GachuhiWachira/CubeSat/LibreCube PCDU/LibreCube_Original_v3/README.md

# LibreCube / Platform / Power / Power Module

A basic Power Conditioning and Distribution Unit (PCDU) that
implements a full redundancy scheme and adheres to the LibreCube board
specification. The main features are:

- Input connectors for up to six solar cells (in configurations for up to 5 Volt)
- Conditioning of input power (linear energy transfer mode)
- Two Li-Ion batteries integrated on board
- Charge and discharge circuitry for batteries, depending on solar input and load
- Main power switch that disconnects all electrical loads from solar cell input and batteries
- Stable 5 Volt output power to attached loads
- Eight output switches for switchable loads

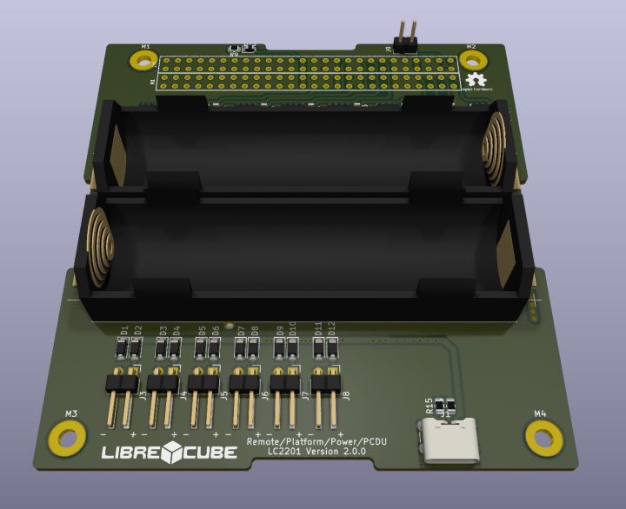
[picture p1: LibreCube PCDU/LibreCube_Original_v3/docs/image_01.png]


The user manual can be found [here](docs/manual/README.md).

## How to Build

See [here](docs/assembly/README.md) for instructions.

## How to Modify

The `src` folder contains the [KiCAD](https://www.kicad.org/) source files.

## Contribute

To learn more on how to successfully contribute please read the contributing
information in the [LibreCube Guidelines](https://librecube.gitlab.io/).

Want to get involved? Join us at [Matrix](https://app.element.io/#/room/#librecube.org:matrix.org)
or via [Email](mailto:info@librecube.org).

## License

The project is licensed under the CERN Open Hardware license.
See the [LICENSE](./LICENSE.txt) file for details.
