GachuhiWachira/CubeSat/LibreCube PCDU/LibreCube Board Template/src/mechanical/board without header with hole.FCStd

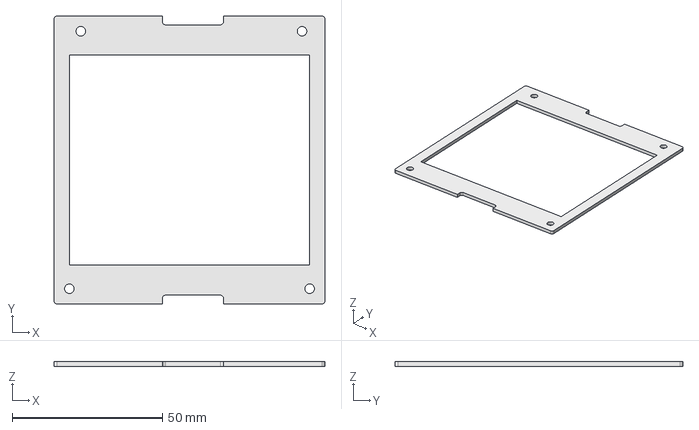
[picture p4: CAD file, 2024-09-18]
LibreCube PCDU/LibreCube Board Template/src/mechanical/board without header with hole.FCStd
90.2 x 95.9 x 1.57 mm
