GachuhiWachira/CubeSat/LibreCube PCDU/LibreCube Board Template/src/mechanical/board_2d_projection.scad

projection(cut=true) import("board.stl");
