GachuhiWachira/CubeSat/LibreCube PCDU/LibreCube_Original_v3/build/schematics.pdf

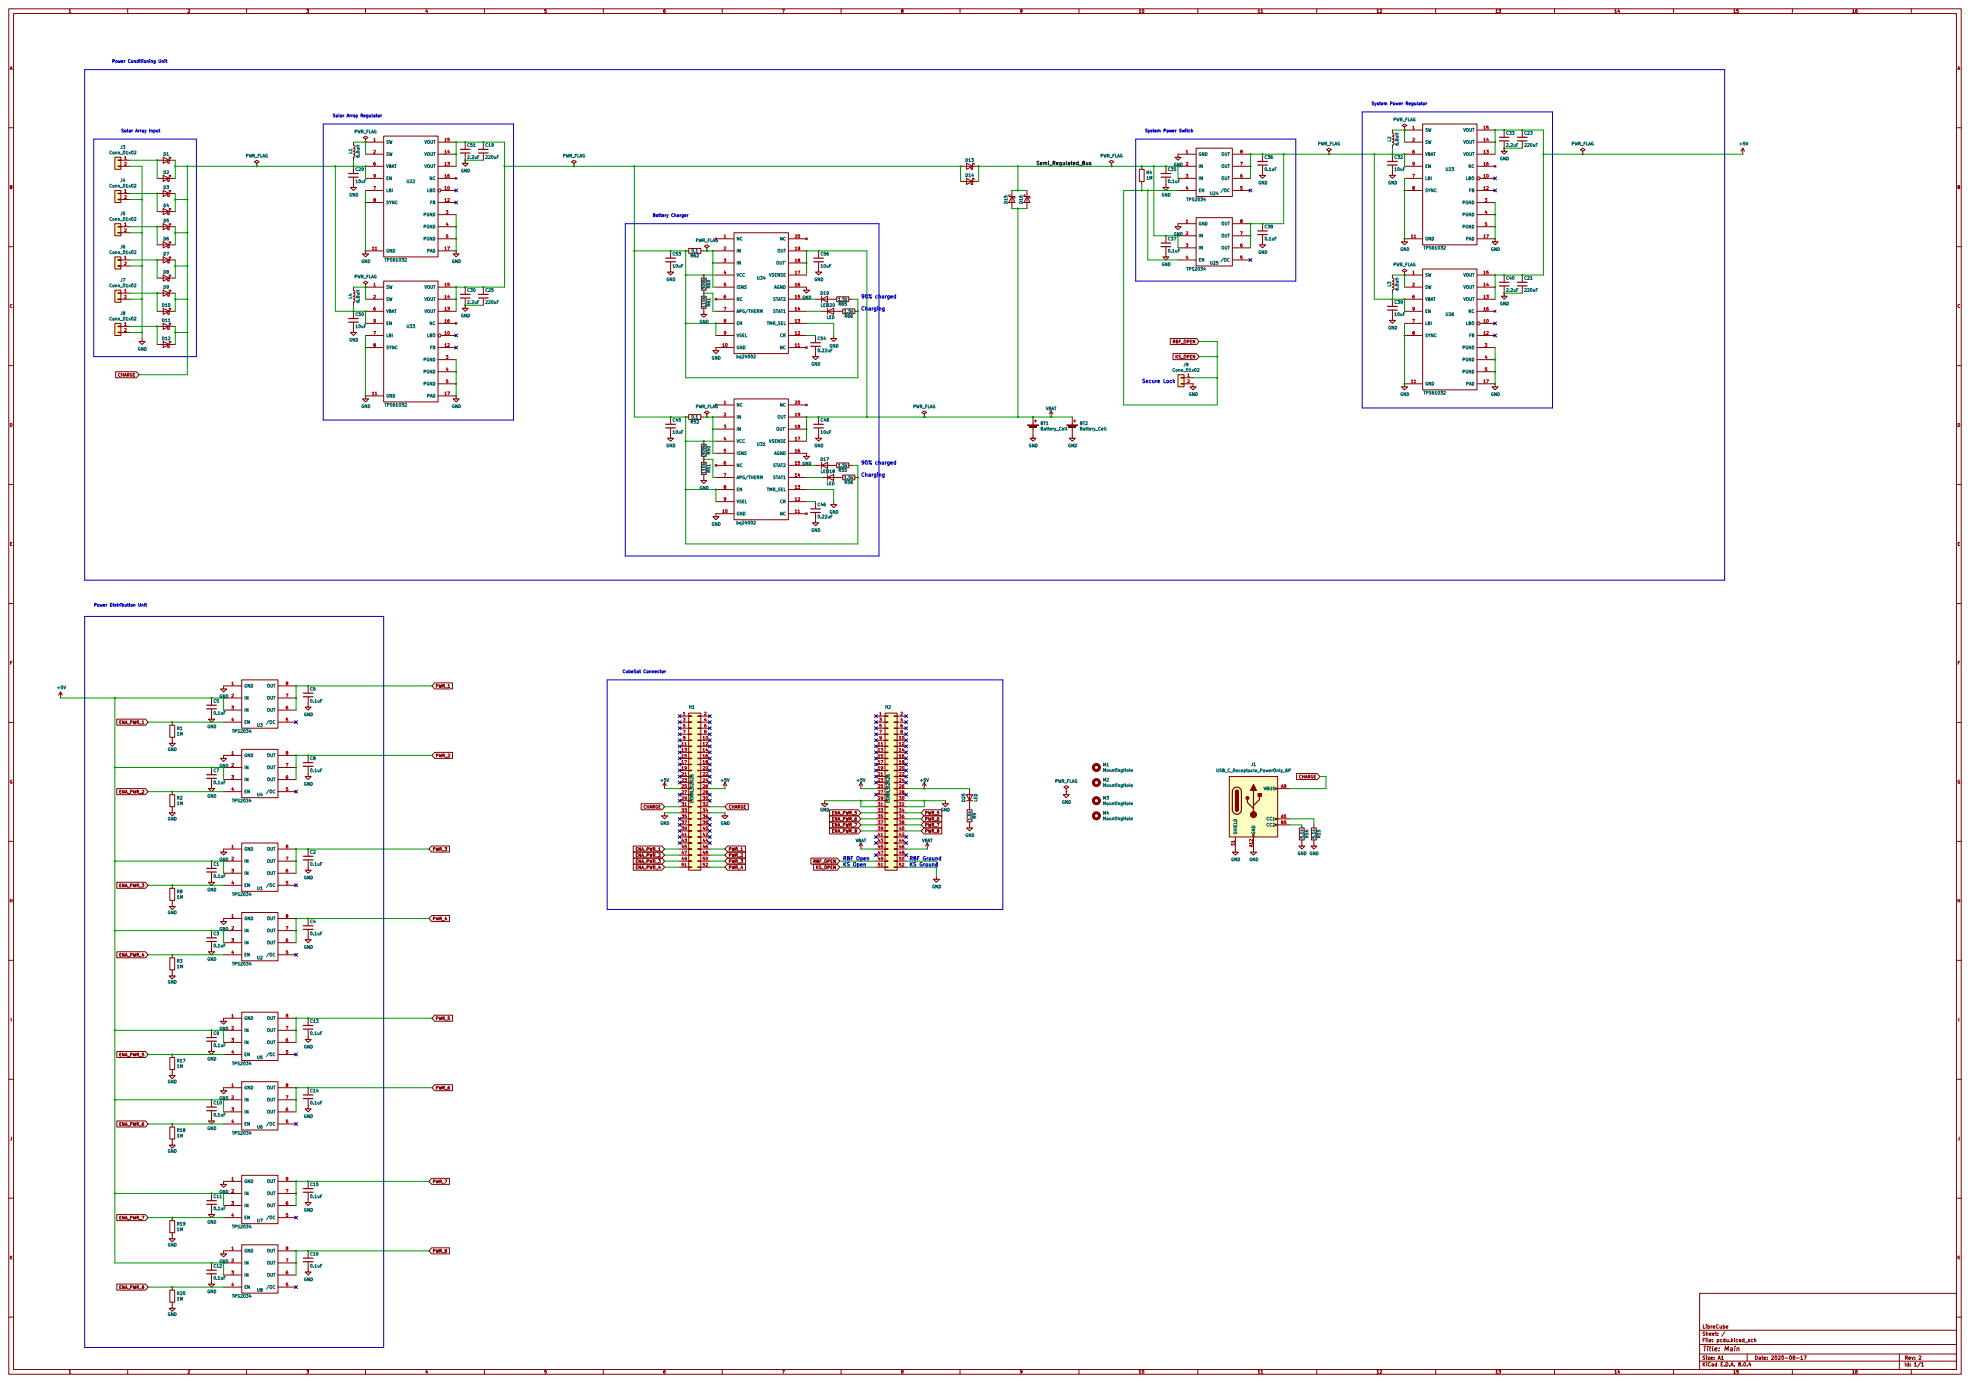
[picture p9: page 1]
