GachuhiWachira/CubeSat/LibreCube PCDU/LibreCube_Original_v2/build/schematics.pdf

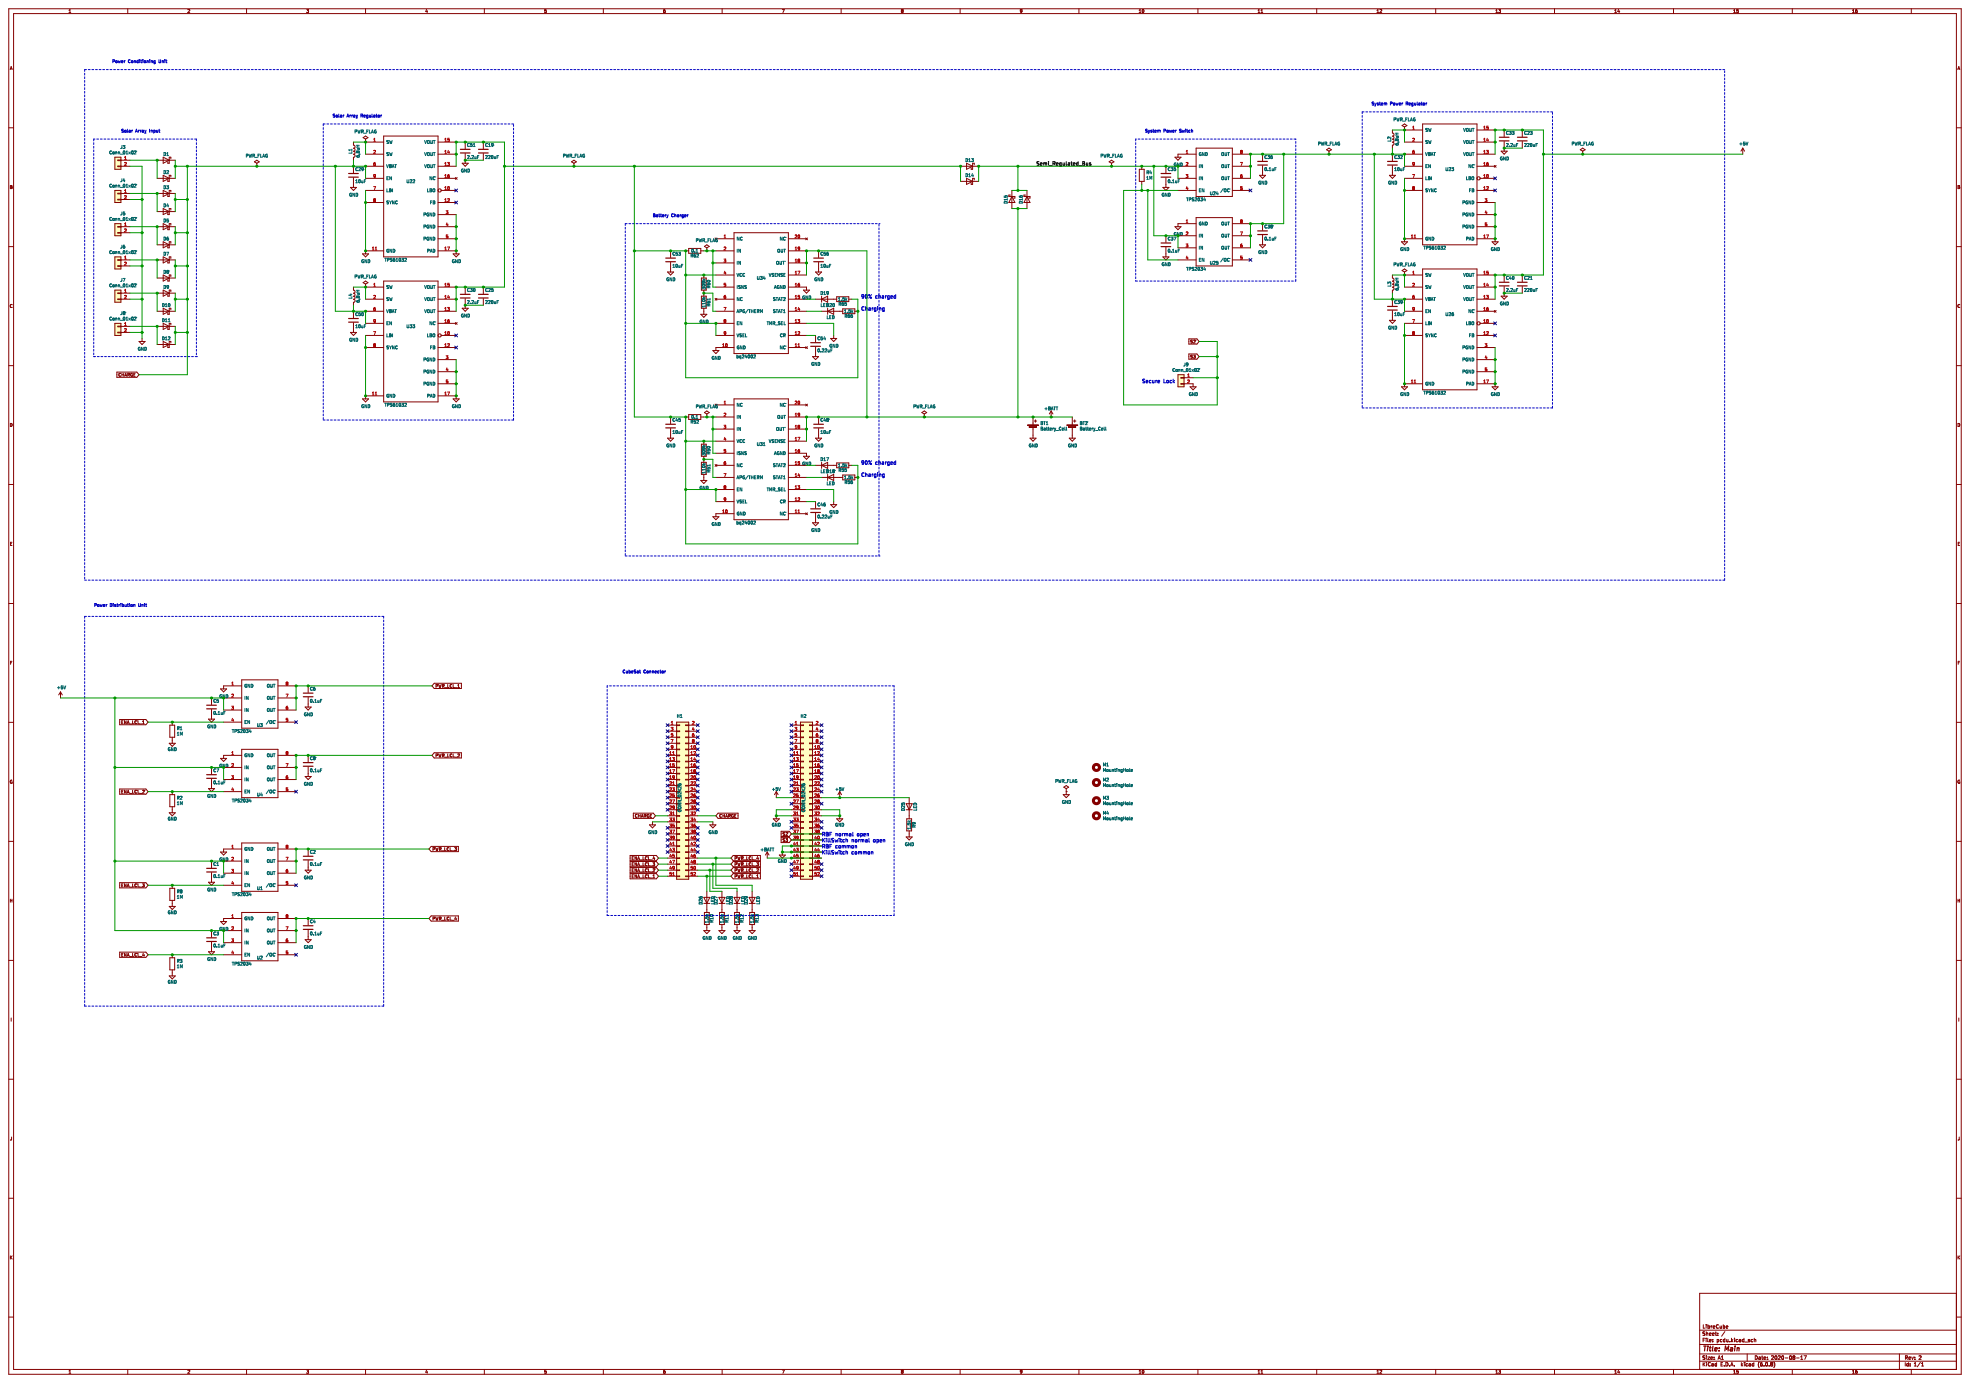
[picture p10: page 1]
