GachuhiWachira/CubeSat/LibreCube PCDU/My version/src/electrical/my_pcdu_v1.kicad_pcb

## KiCad design LibreCube PCDU/My version/src/electrical/my_pcdu_v1.kicad_pcb (2025-06-23)

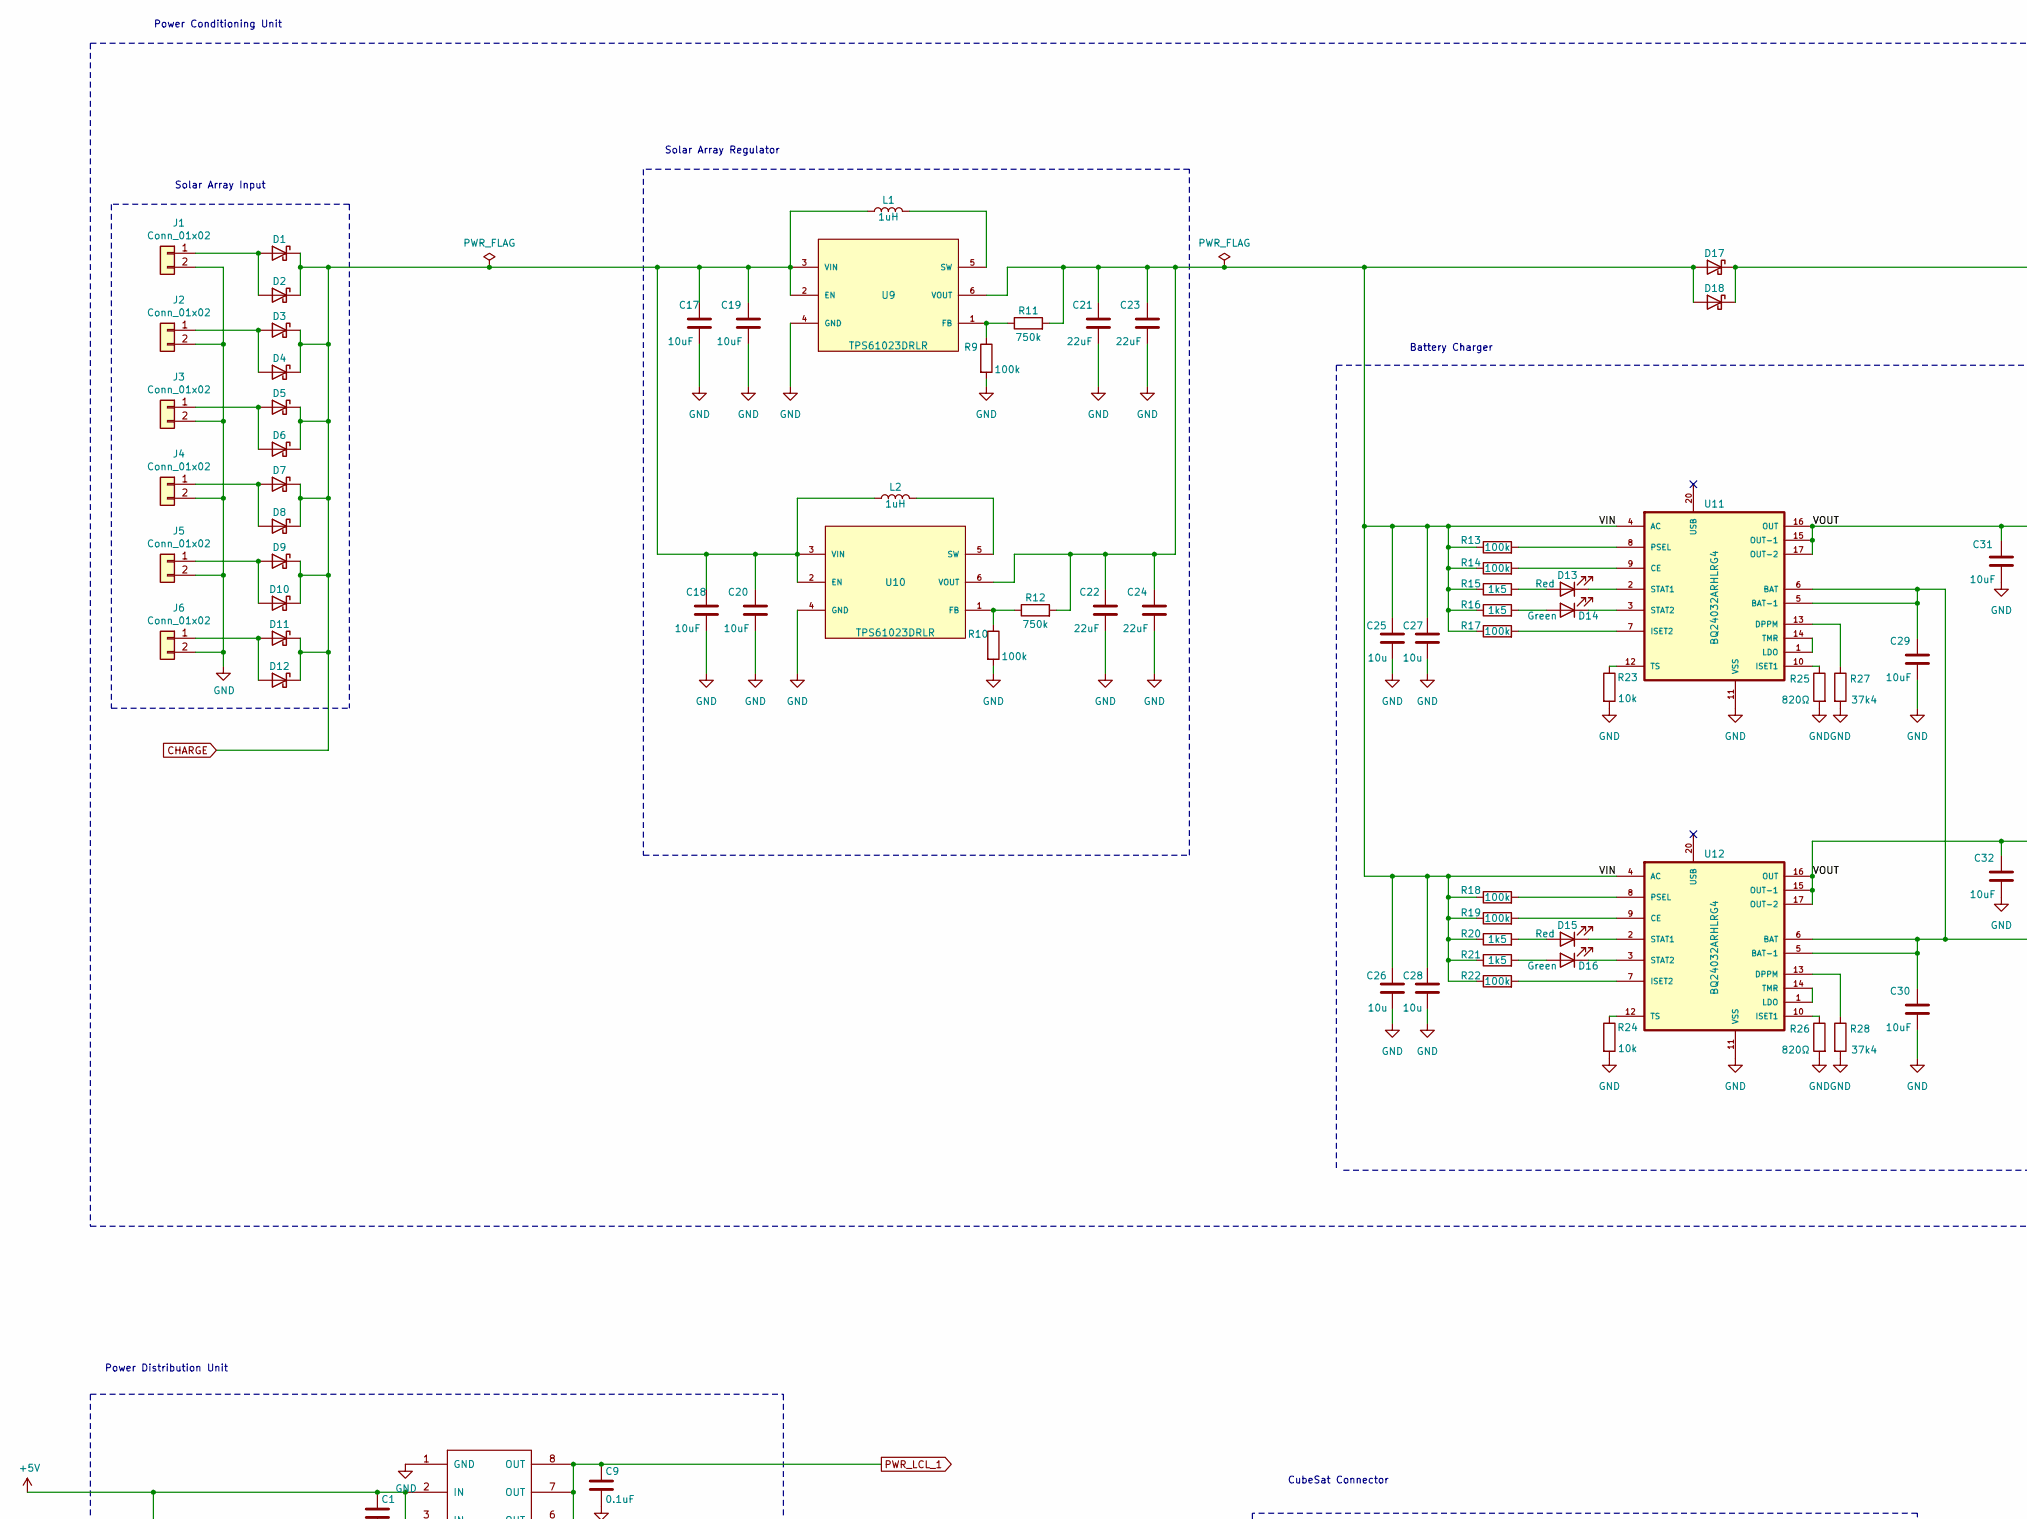
[picture p11: schematic my_pcdu_v1.kicad_sch, LibreCube PCDU 4-Layer (LC2201), part in row 1, column 1]

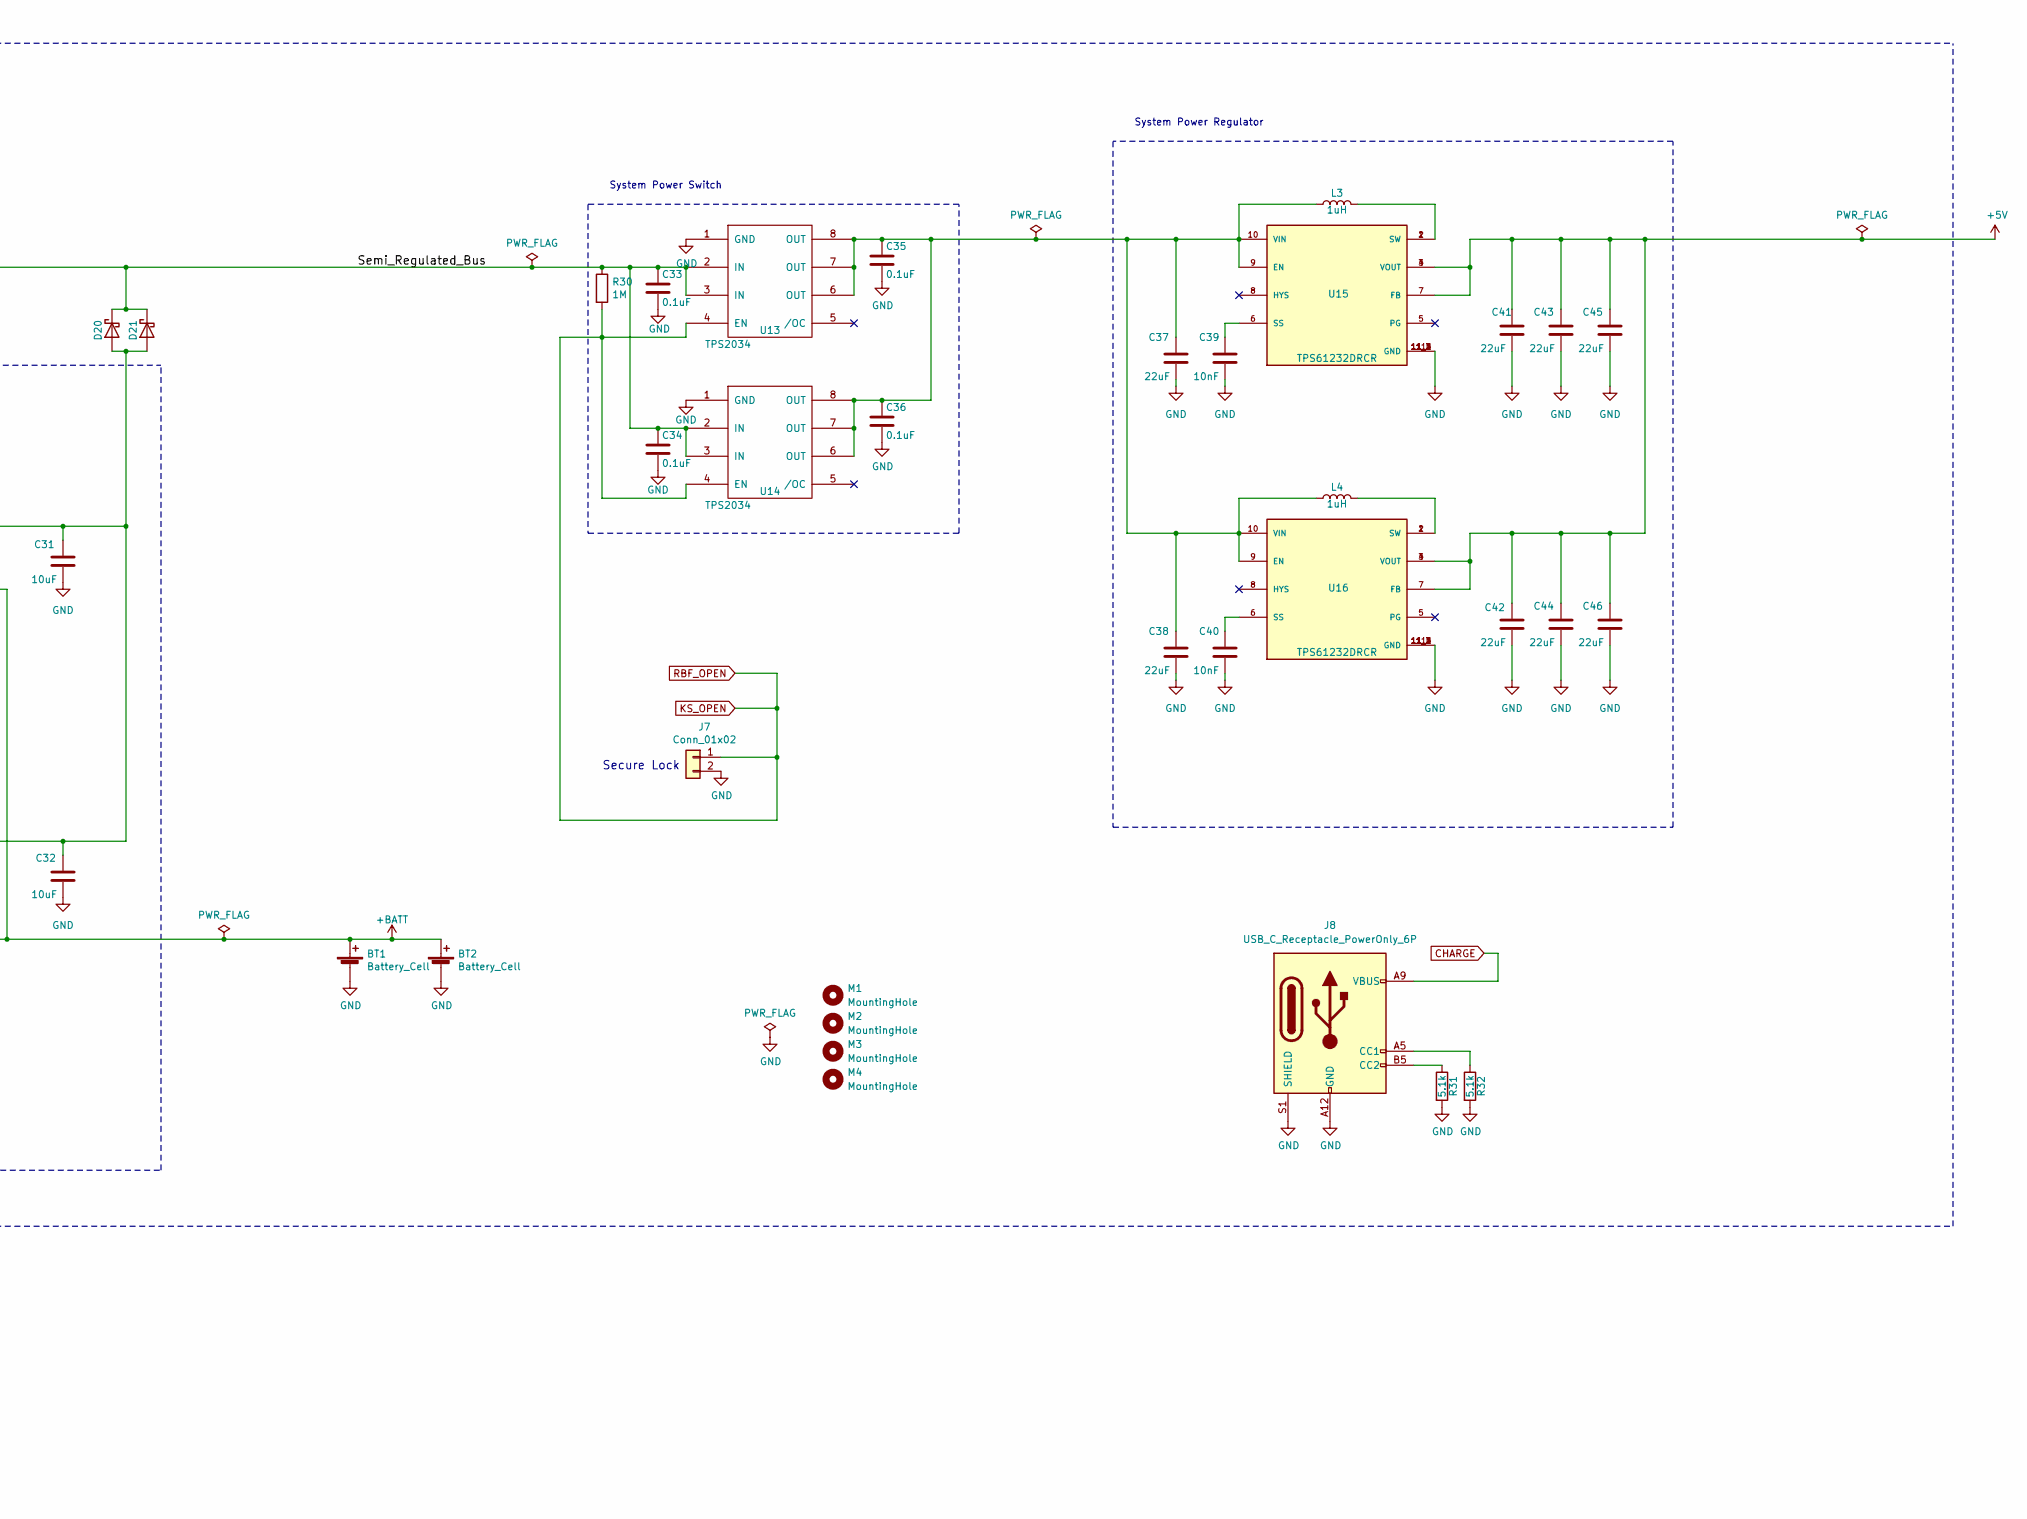
[picture p12: schematic my_pcdu_v1.kicad_sch, LibreCube PCDU 4-Layer (LC2201), part in row 1, column 2]

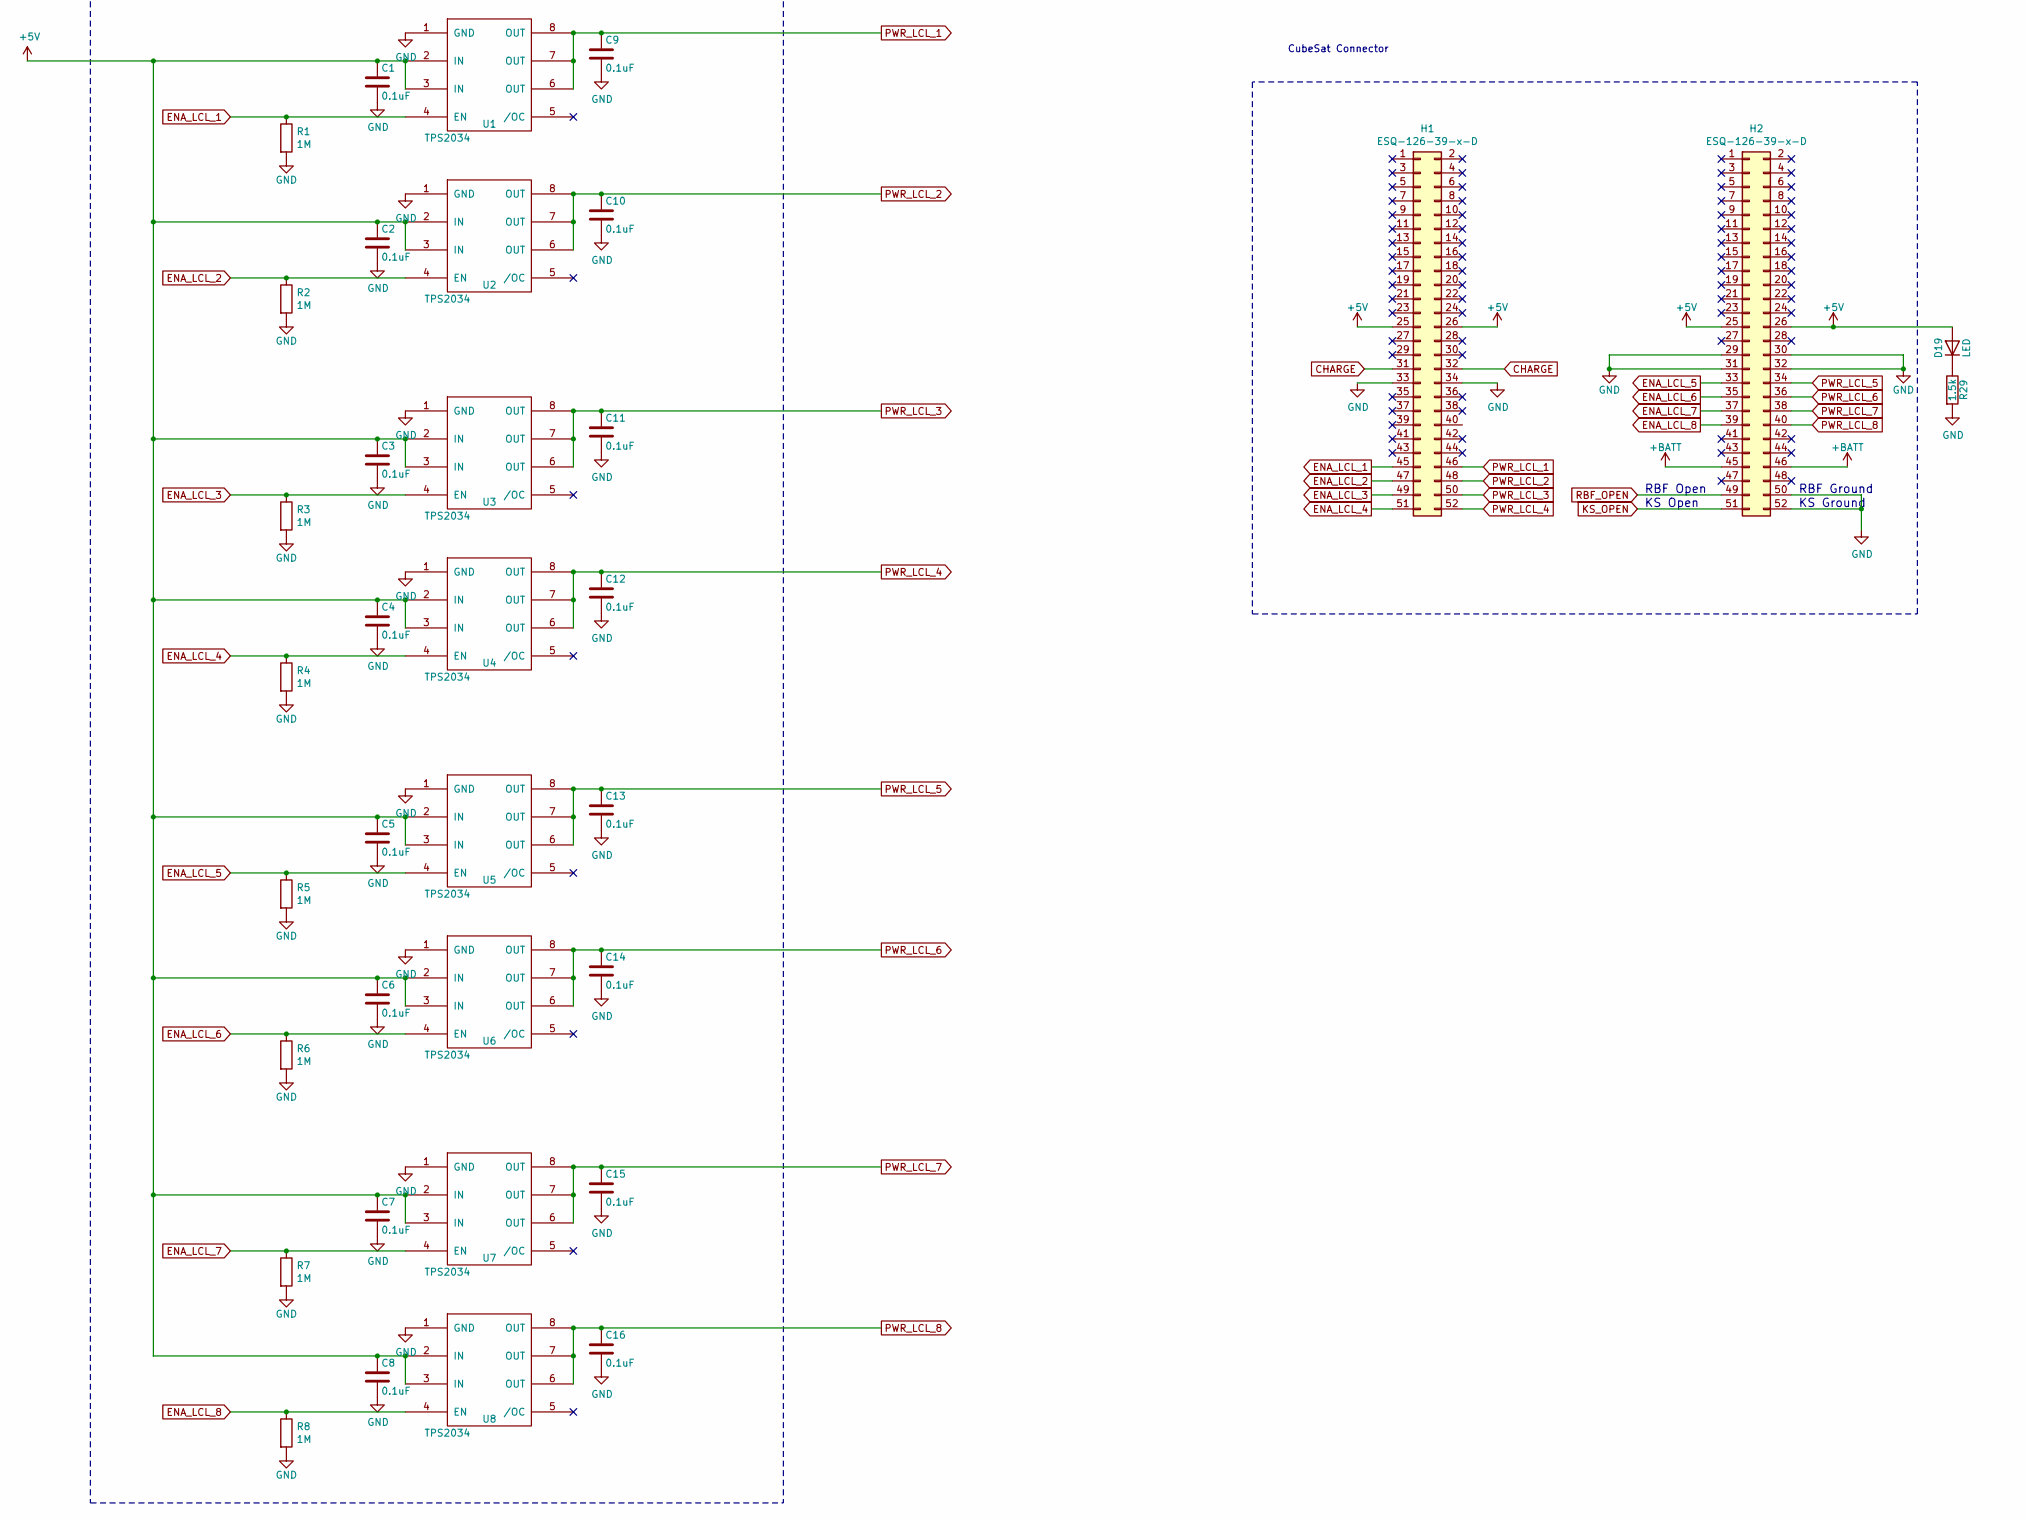
[picture p13: schematic my_pcdu_v1.kicad_sch, LibreCube PCDU 4-Layer (LC2201), part in row 2, column 1]

Parts:
BT1, BT2: Battery_Cell; BatteryHolder_Keystone_1042_1x18650
C1, C2, C3, C4, C5, C6, C7, C8, C9, C10, C11, C12, C13, C14, C15, C16, C33, C34, C35, C36: 0.1uF; C_0805_2012Metric
C17, C18, C19, C20, C29, C30, C31, C32: 10uF; C_0805_2012Metric_Pad1.18x1.45mm_HandSolder
C21, C22, C23, C24, C37, C38, C41, C42, C43, C44, C45, C46: 22uF; C_0805_2012Metric_Pad1.18x1.45mm_HandSolder
C25, C26, C27, C28: 10u; C_1206_3216Metric_Pad1.33x1.80mm_HandSolder
C39, C40: 10nF; C_0805_2012Metric_Pad1.18x1.45mm_HandSolder
D1, D2, D3, D4, D5, D6, D7, D8, D9, D10, D11, D12, D17, D18, D20, D21: D_Schottky; D_SOD-123
D13, D15: Red; LED_0805_2012Metric_Pad1.15x1.40mm_HandSolder
D14, D16: Green; LED_0805_2012Metric_Pad1.15x1.40mm_HandSolder
D19: LED; D_0805_2012Metric
H1, H2: ESQ-126-39-x-D; PinHeader_2x26_P2.54mm_Vertical
J1, J2, J3, J4, J5, J6: Conn_01x02; PinHeader_1x02_P2.54mm_Horizontal
J7: Conn_01x02; PinHeader_1x02_P2.54mm_Vertical
J8: USB_C_Receptacle_PowerOnly_6P; USB_C_Receptacle_GCT_USB4125-xx-x-0190_6P_TopMnt_Horizontal
L1, L2, L3, L4: 1uH; L_Coilcraft_XAL4040-XXX
M1, M2, M3, M4: MountingHole; MountingHole_3.2mm_M3_Pad
R1, R2, R3, R4, R5, R6, R7, R8, R30: 1M; R_0805_2012Metric
R9, R10, R13, R14, R17, R18, R19, R22: 100k; R_0805_2012Metric_Pad1.20x1.40mm_HandSolder
R11, R12: 750k; R_0805_2012Metric_Pad1.20x1.40mm_HandSolder
R15, R16, R20, R21: 1k5; R_0805_2012Metric_Pad1.20x1.40mm_HandSolder
R23, R24: 10k; R_0805_2012Metric_Pad1.20x1.40mm_HandSolder
R25, R26: 820Ω; R_0805_2012Metric_Pad1.20x1.40mm_HandSolder
R27, R28: 37k4; R_0805_2012Metric_Pad1.20x1.40mm_HandSolder
R29: 1.5k; R_0805_2012Metric
R31, R32: 5.1k; R_0805_2012Metric
REF1: Logo_Open_Hardware_Small; OSHW-Logo_5.7x6mm_SilkScreen
U1, U2, U3, U4, U5, U6, U7, U8, U13, U14: TPS2034; SO-8_3.9x4.9mm_P1.27mm
U9, U10: TPS61023DRLR; DRL0006A; PARTNUMBER TPS61023DRL
U11, U12: BQ24032ARHLRG4; IC_MSP430FR2522IRHLR
U15, U16: TPS61232DRCR; VREG_TPS61232DRCR; PARTREV C

Connections:
+5V: C1.1, C2.1, C3.1, C4.1, C5.1, C6.1, C7.1, C8.1, C41.1, C42.1, C43.1, C44.1, C45.1, C46.1, D19.2 (A), H1.25, H1.26, H2.25, H2.26, U1.2 (IN), U1.3 (IN), U2.2 (IN), U2.3 (IN), U3.2 (IN), U3.3 (IN), U4.2 (IN), U4.3 (IN), U5.2 (IN), U5.3 (IN), U6.2 (IN), U6.3 (IN), U7.2 (IN), U7.3 (IN), U8.2 (IN), U8.3 (IN), U15.3 (VOUT), U15.4 (VOUT), U15.7 (FB), U16.3 (VOUT), U16.4 (VOUT), U16.7 (FB)
+BATT: BT1.1 (+), BT2.1 (+), C29.1, C30.1, H2.45, H2.46, U11.5 (BAT-1), U11.6 (BAT), U12.5 (BAT-1), U12.6 (BAT)
/Semi_Regulated_Bus: C33.1, C34.1, D17.1 (K), D18.1 (K), D20.1 (K), D21.1 (K), R30.1, U13.2 (IN), U13.3 (IN), U14.2 (IN), U14.3 (IN)
/VIN: C21.1, C22.1, C23.1, C24.1, C25.1, C26.1, C27.1, C28.1, D17.2 (A), D18.2 (A), R11.2, R12.2, R13.1, R14.1, R15.1, R16.1, R17.1, R18.1, R19.1, R20.1, R21.1, R22.1, U9.6 (VOUT), U10.6 (VOUT), U11.4 (AC), U12.4 (AC)
/VOUT: C31.1, C32.1, D20.2 (A), D21.2 (A), U11.15 (OUT-1), U11.16 (OUT), U11.17 (OUT-2), U12.15 (OUT-1), U12.16 (OUT), U12.17 (OUT-2)
CHARGE: C17.1, C18.1, C19.1, C20.1, D1.1 (K), D2.1 (K), D3.1 (K), D4.1 (K), D5.1 (K), D6.1 (K), D7.1 (K), D8.1 (K), D9.1 (K), D10.1 (K), D11.1 (K), D12.1 (K), H1.31, H1.32, J8.A9 (VBUS), J8.B9 (VBUS), L1.1, L2.1, U9.2 (EN), U9.3 (VIN), U10.2 (EN), U10.3 (VIN)
ENA_LCL_1: H1.45, R1.1, U1.4 (EN)
ENA_LCL_2: H1.47, R2.1, U2.4 (EN)
ENA_LCL_3: H1.49, R3.1, U3.4 (EN)
ENA_LCL_4: H1.51, R4.1, U4.4 (EN)
ENA_LCL_5: H2.33, R5.1, U5.4 (EN)
ENA_LCL_6: H2.35, R6.1, U6.4 (EN)
ENA_LCL_7: H2.37, R7.1, U7.4 (EN)
ENA_LCL_8: H2.39, R8.1, U8.4 (EN)
GND: BT1.2 (-), BT2.2 (-), C1.2, C2.2, C3.2, C4.2, C5.2, C6.2, C7.2, C8.2, C9.2, C10.2, C11.2, C12.2, C13.2, C14.2, C15.2, C16.2, C17.2, C18.2, C19.2, C20.2, C21.2, C22.2, C23.2, C24.2, C25.2, C26.2, C27.2, C28.2, C29.2, C30.2, C31.2, C32.2, C33.2, C34.2, C35.2, C36.2, C37.2, C38.2, C39.2, C40.2, C41.2, C42.2, C43.2, C44.2, C45.2, C46.2, H1.33, H1.34, H2.29, H2.30, H2.31, H2.32, H2.50, H2.52, J1.2, J2.2, J3.2, J4.2, J5.2, J6.2, J7.2, J8.A12 (GND), J8.B12 (GND), J8.S1 (SHIELD), R1.2, R2.2, R3.2, R4.2, R5.2, R6.2, R7.2, R8.2, R9.2, R10.2, R23.2, R24.2, R25.2, R26.2, R27.2, R28.2, R29.2, R31.2, R32.2, U1.1 (GND), U2.1 (GND), U3.1 (GND), U4.1 (GND), U5.1 (GND), U6.1 (GND), U7.1 (GND), U8.1 (GND), U9.4 (GND), U10.4 (GND), U11.11 (VSS), U11.21 (PwrPad), U11.22, U11.23, U11.24, U11.25, U11.26, U11.27, U11.28, U11.29, U12.11 (VSS), U12.21 (PwrPad), U12.22, U12.23, U12.24, U12.25, U12.26, U12.27, U12.28, U12.29, U13.1 (GND), U14.1 (GND), U15.11 (GND), U15.11_1 (GND), U15.11_2 (GND), U15.11_3 (GND), U15.11_4 (GND), U16.11 (GND), U16.11_1 (GND), U16.11_2 (GND), U16.11_3 (GND), U16.11_4 (GND)
KS_OPEN: H2.49, H2.51, J7.1, R30.2, U13.4 (EN), U14.4 (EN)
unnamed: D1.2 (A), D2.2 (A), J1.1
unnamed: D3.2 (A), D4.2 (A), J2.1
unnamed: D5.2 (A), D6.2 (A), J3.1
unnamed: D7.2 (A), D8.2 (A), J4.1
unnamed: D9.2 (A), D10.2 (A), J5.1
unnamed: D11.2 (A), D12.2 (A), J6.1
unnamed: D13.2 (A), R15.2
unnamed: D13.1 (K), U11.2 (STAT1)
unnamed: D14.2 (A), R16.2
unnamed: D14.1 (K), U11.3 (STAT2)
unnamed: D15.2 (A), R20.2
unnamed: D15.1 (K), U12.2 (STAT1)
unnamed: D16.2 (A), R21.2
unnamed: D16.1 (K), U12.3 (STAT2)
unnamed: D19.1 (K), R29.1
unnamed: J8.A5 (CC1), R32.1
unnamed: J8.B5 (CC2), R31.1
unnamed: L3.2, U15.1 (SW), U15.2 (SW)
unnamed: L4.2, U16.1 (SW), U16.2 (SW)
unnamed: R9.1, R11.1, U9.1 (FB)
unnamed: L1.2, U9.5 (SW)
unnamed: R10.1, R12.1, U10.1 (FB)
unnamed: L2.2, U10.5 (SW)
unnamed: R14.2, U11.9 (CE)
unnamed: R27.1, U11.13 (DPPM)
unnamed: R25.1, U11.10 (ISET1)
unnamed: R17.2, U11.7 (ISET2)
unnamed: U11.1 (LDO), U11.14 (TMR)
unnamed: R13.2, U11.8 (PSEL)
unnamed: R23.1, U11.12 (TS)
unnamed: R19.2, U12.9 (CE)
unnamed: R28.1, U12.13 (DPPM)
unnamed: R26.1, U12.10 (ISET1)
unnamed: R22.2, U12.7 (ISET2)
unnamed: U12.1 (LDO), U12.14 (TMR)
unnamed: R18.2, U12.8 (PSEL)
unnamed: R24.1, U12.12 (TS)
unnamed: C35.1, C36.1, C37.1, C38.1, L3.1, L4.1, U13.6 (OUT), U13.7 (OUT), U13.8 (OUT), U14.6 (OUT), U14.7 (OUT), U14.8 (OUT), U15.9 (EN), U15.10 (VIN), U16.9 (EN), U16.10 (VIN)
unnamed: C39.1, U15.6 (SS)
unnamed: C40.1, U16.6 (SS)
PWR_LCL_1: C9.1, H1.46, U1.6 (OUT), U1.7 (OUT), U1.8 (OUT)
PWR_LCL_2: C10.1, H1.48, U2.6 (OUT), U2.7 (OUT), U2.8 (OUT)
PWR_LCL_3: C11.1, H1.50, U3.6 (OUT), U3.7 (OUT), U3.8 (OUT)
PWR_LCL_4: C12.1, H1.52, U4.6 (OUT), U4.7 (OUT), U4.8 (OUT)
PWR_LCL_5: C13.1, H2.34, U5.6 (OUT), U5.7 (OUT), U5.8 (OUT)
PWR_LCL_6: C14.1, H2.36, U6.6 (OUT), U6.7 (OUT), U6.8 (OUT)
PWR_LCL_7: C15.1, H2.38, U7.6 (OUT), U7.7 (OUT), U7.8 (OUT)
PWR_LCL_8: C16.1, H2.40, U8.6 (OUT), U8.7 (OUT), U8.8 (OUT)

Notes on the sheet:
KS Open
Solar Array Input
Solar Array Regulator
Power Distribution Unit
Secure Lock
System Power Switch
KS Ground
RBF Open
System Power Regulator
Battery Charger
CubeSat Connector
Power Conditioning Unit
RBF Ground

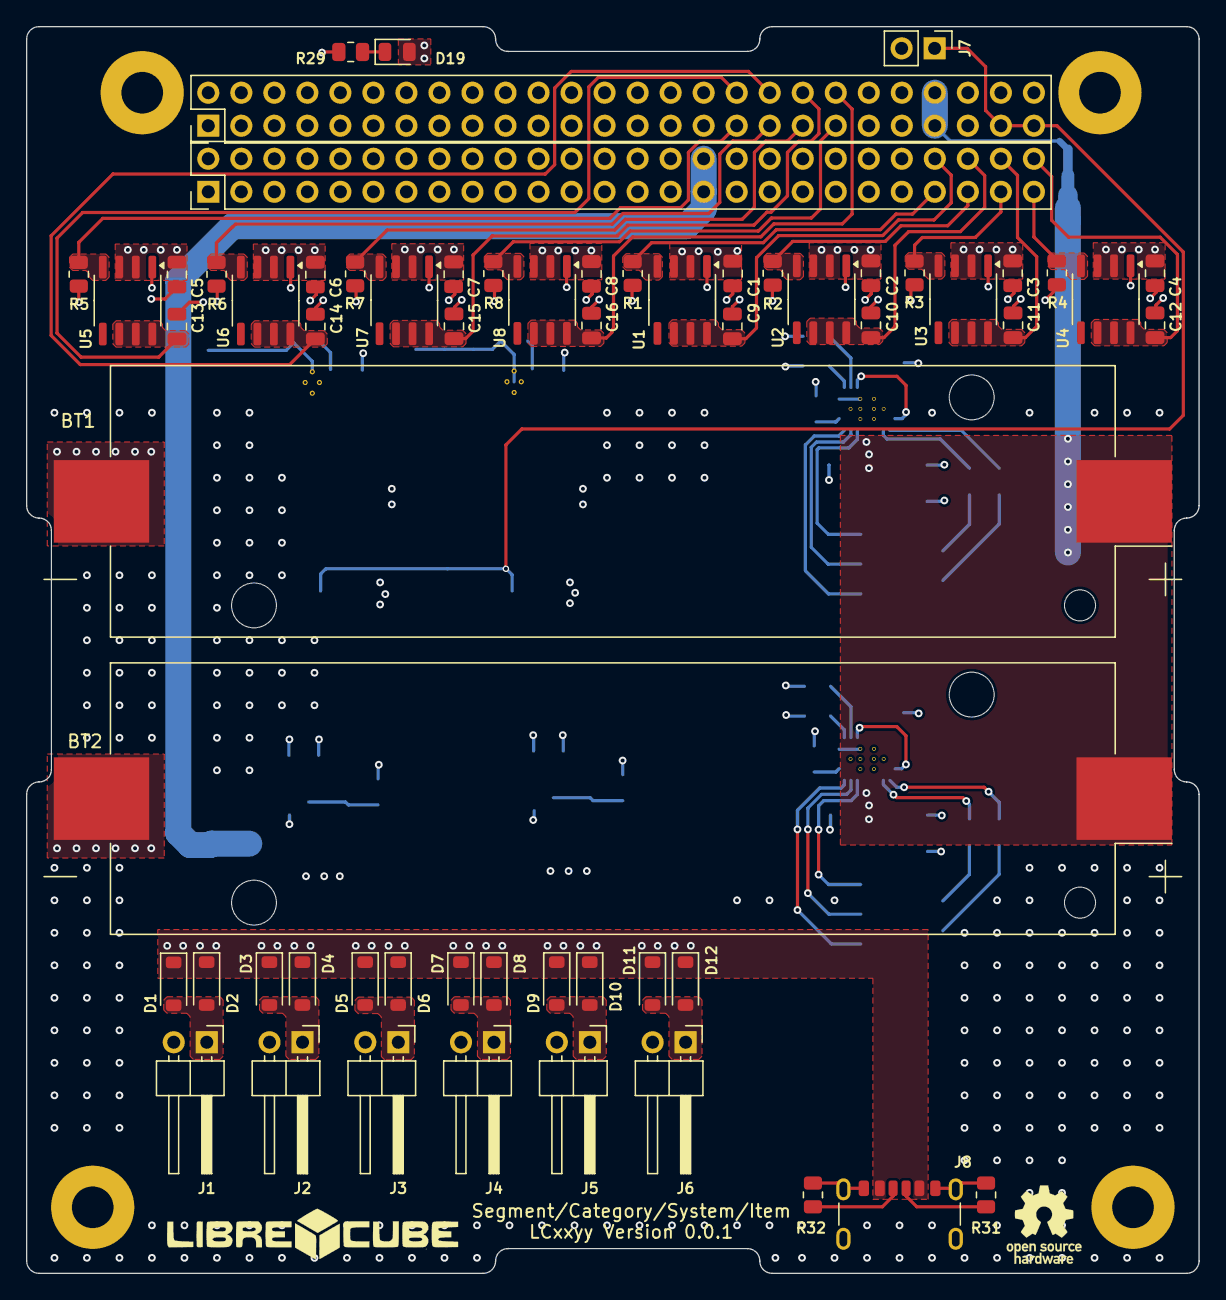
[picture p14: board my_pcdu_v1.kicad_pcb from above]

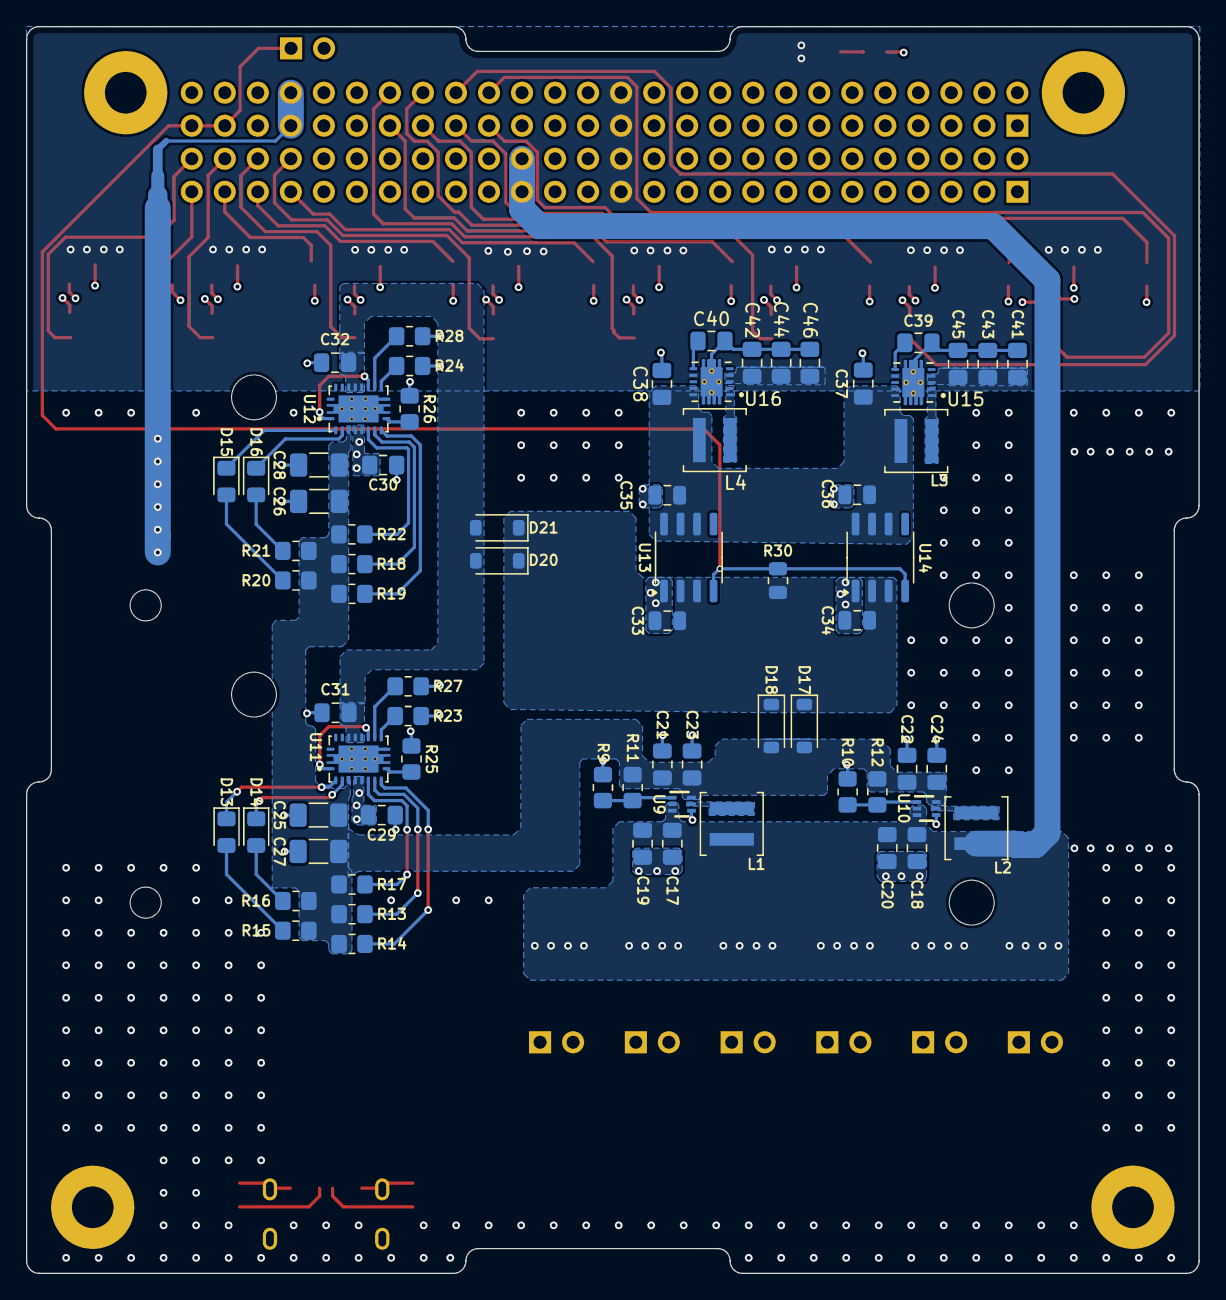
[picture p15: board my_pcdu_v1.kicad_pcb from below]

Board: 4 copper layers, 90.2 x 95.9 mm, 136 parts (71 on the bottom side), 64 nets.
