GachuhiWachira/CubeSat/LibreCube PCDU/LibreCube_Original_v3/src/electrical/pcdu.kicad_pcb

## KiCad design LibreCube PCDU/LibreCube_Original_v3/src/electrical/pcdu.kicad_pcb (2024-09-27)

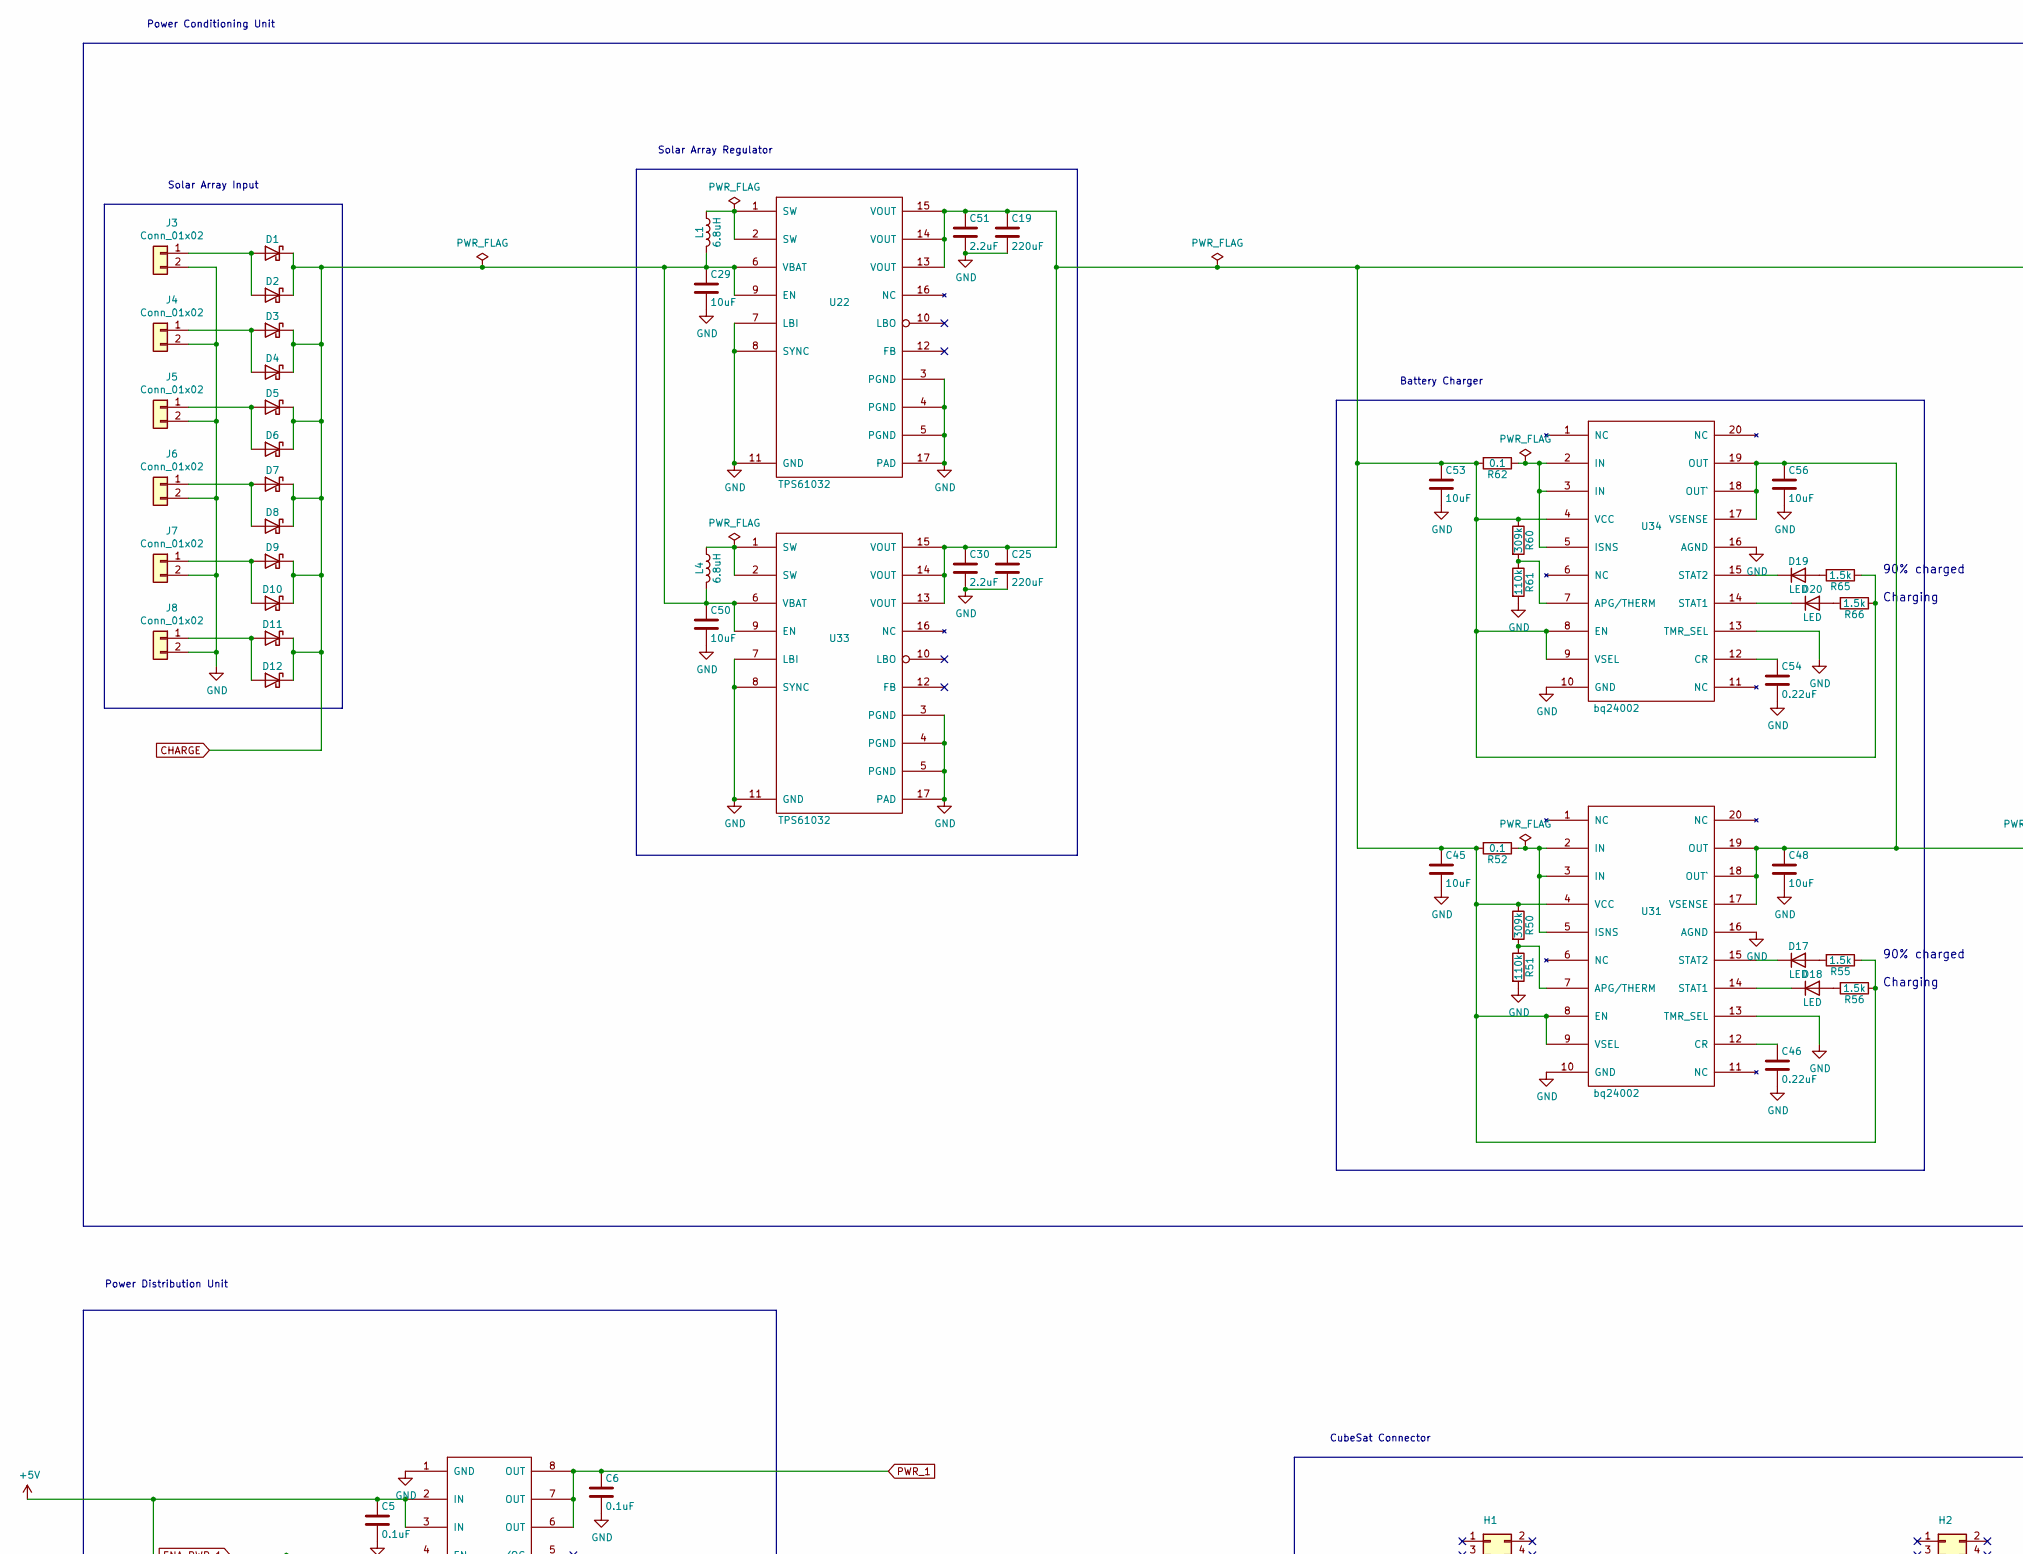
[picture p16: schematic pcdu.kicad_sch, Main, part in row 1, column 1]

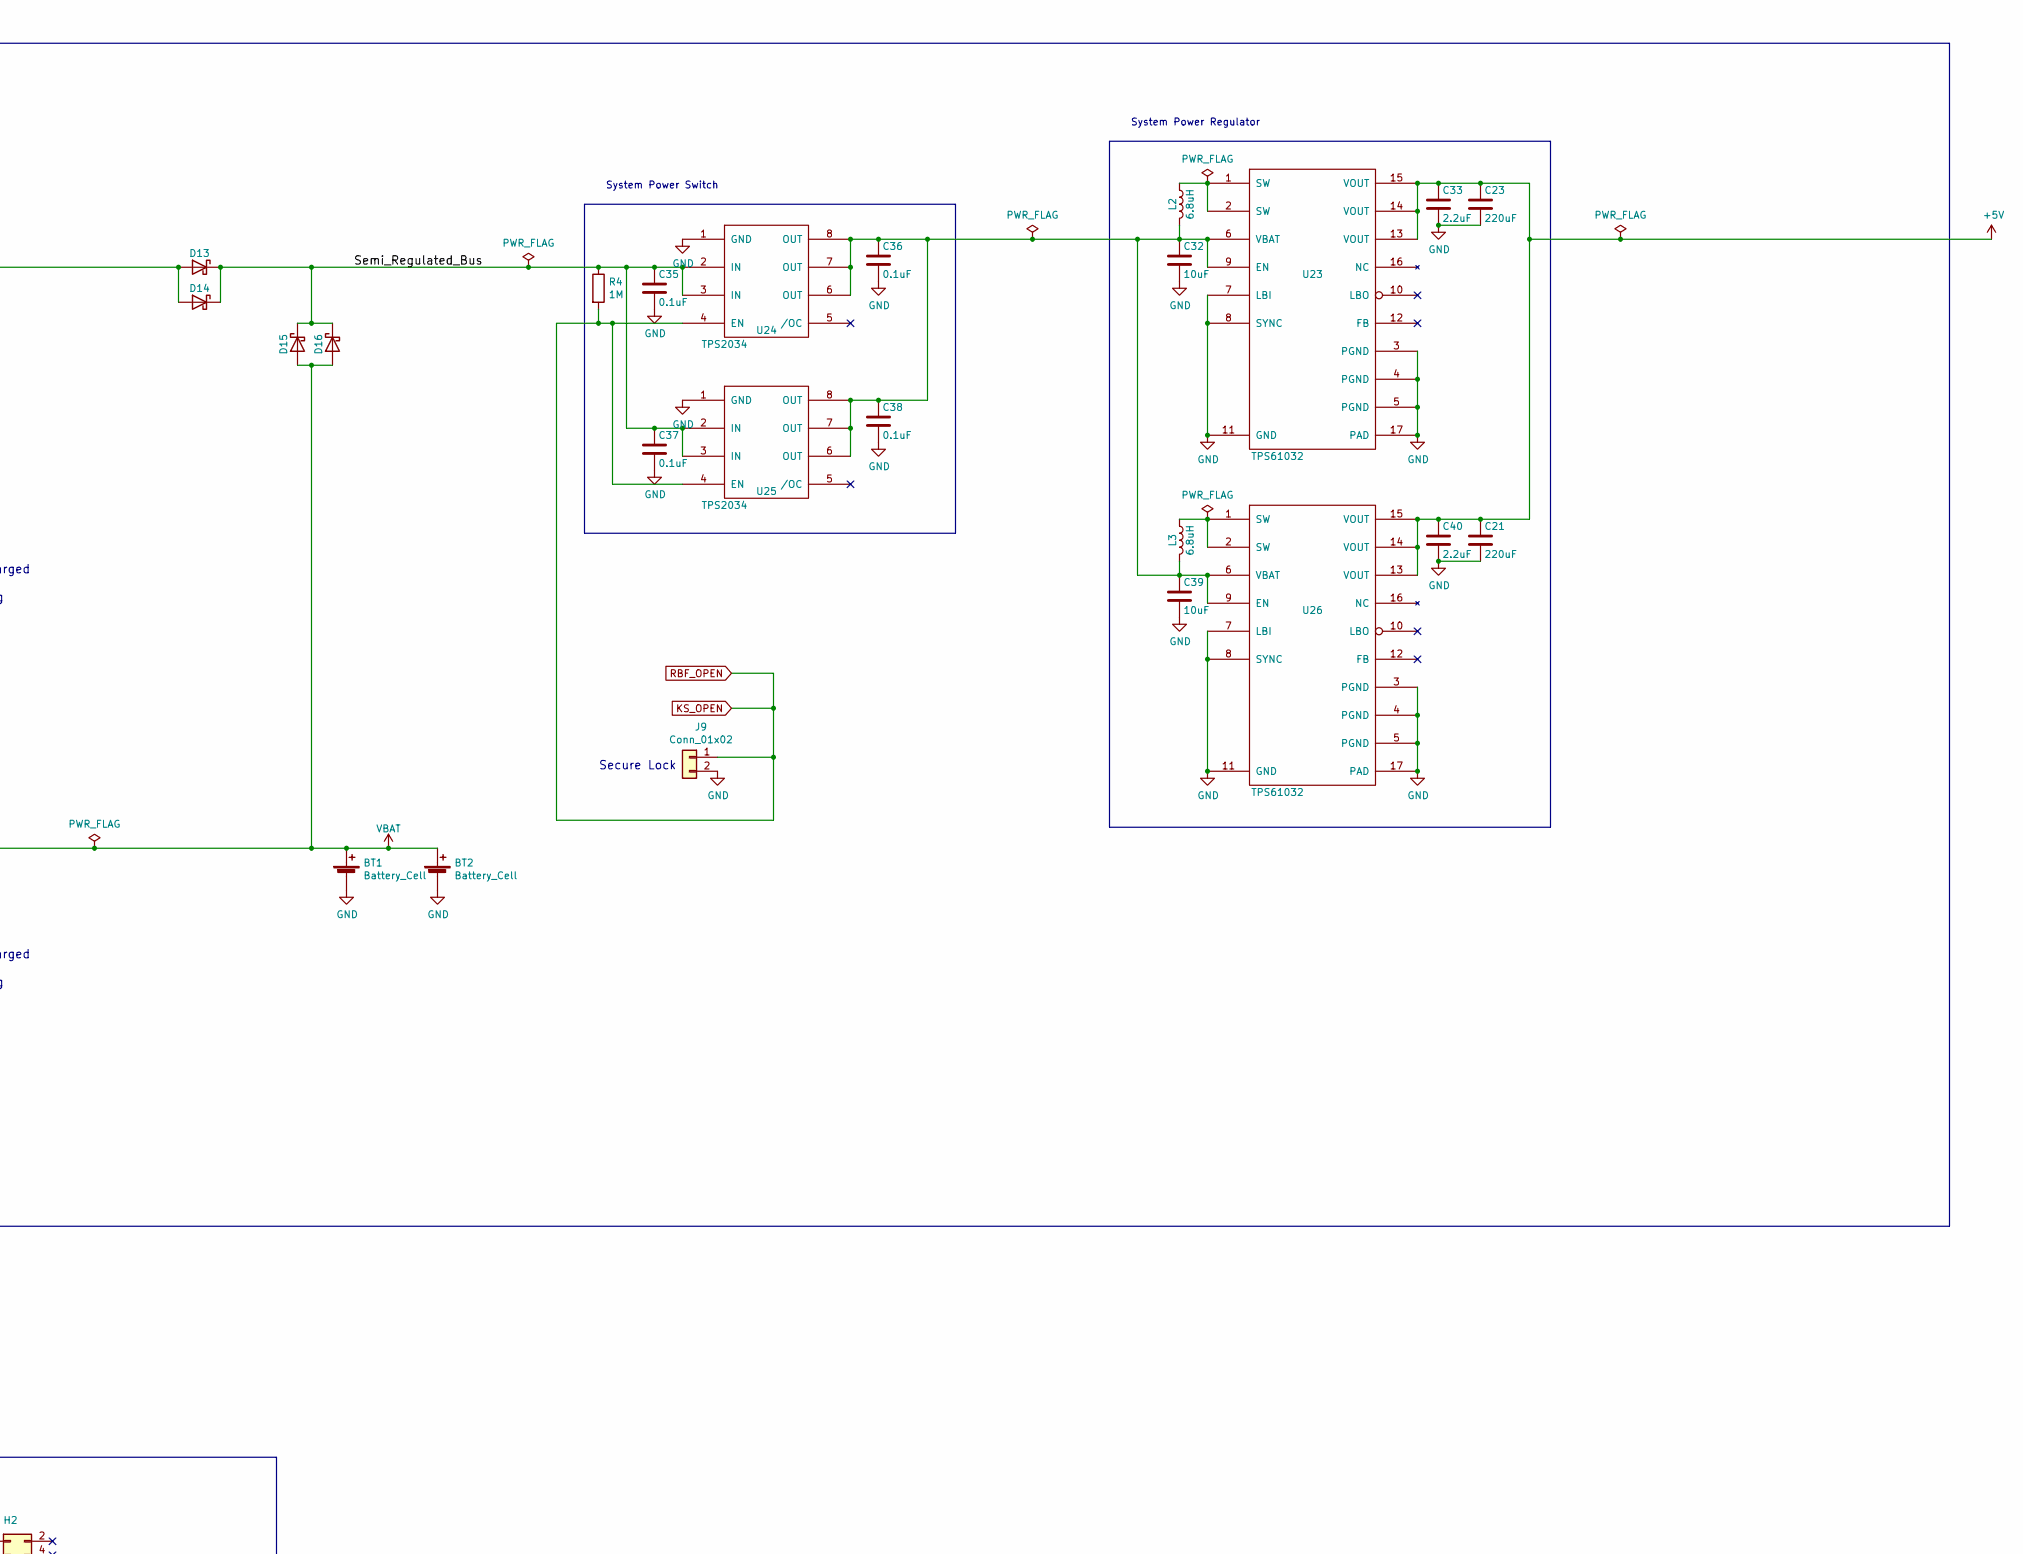
[picture p17: schematic pcdu.kicad_sch, Main, part in row 1, column 2]

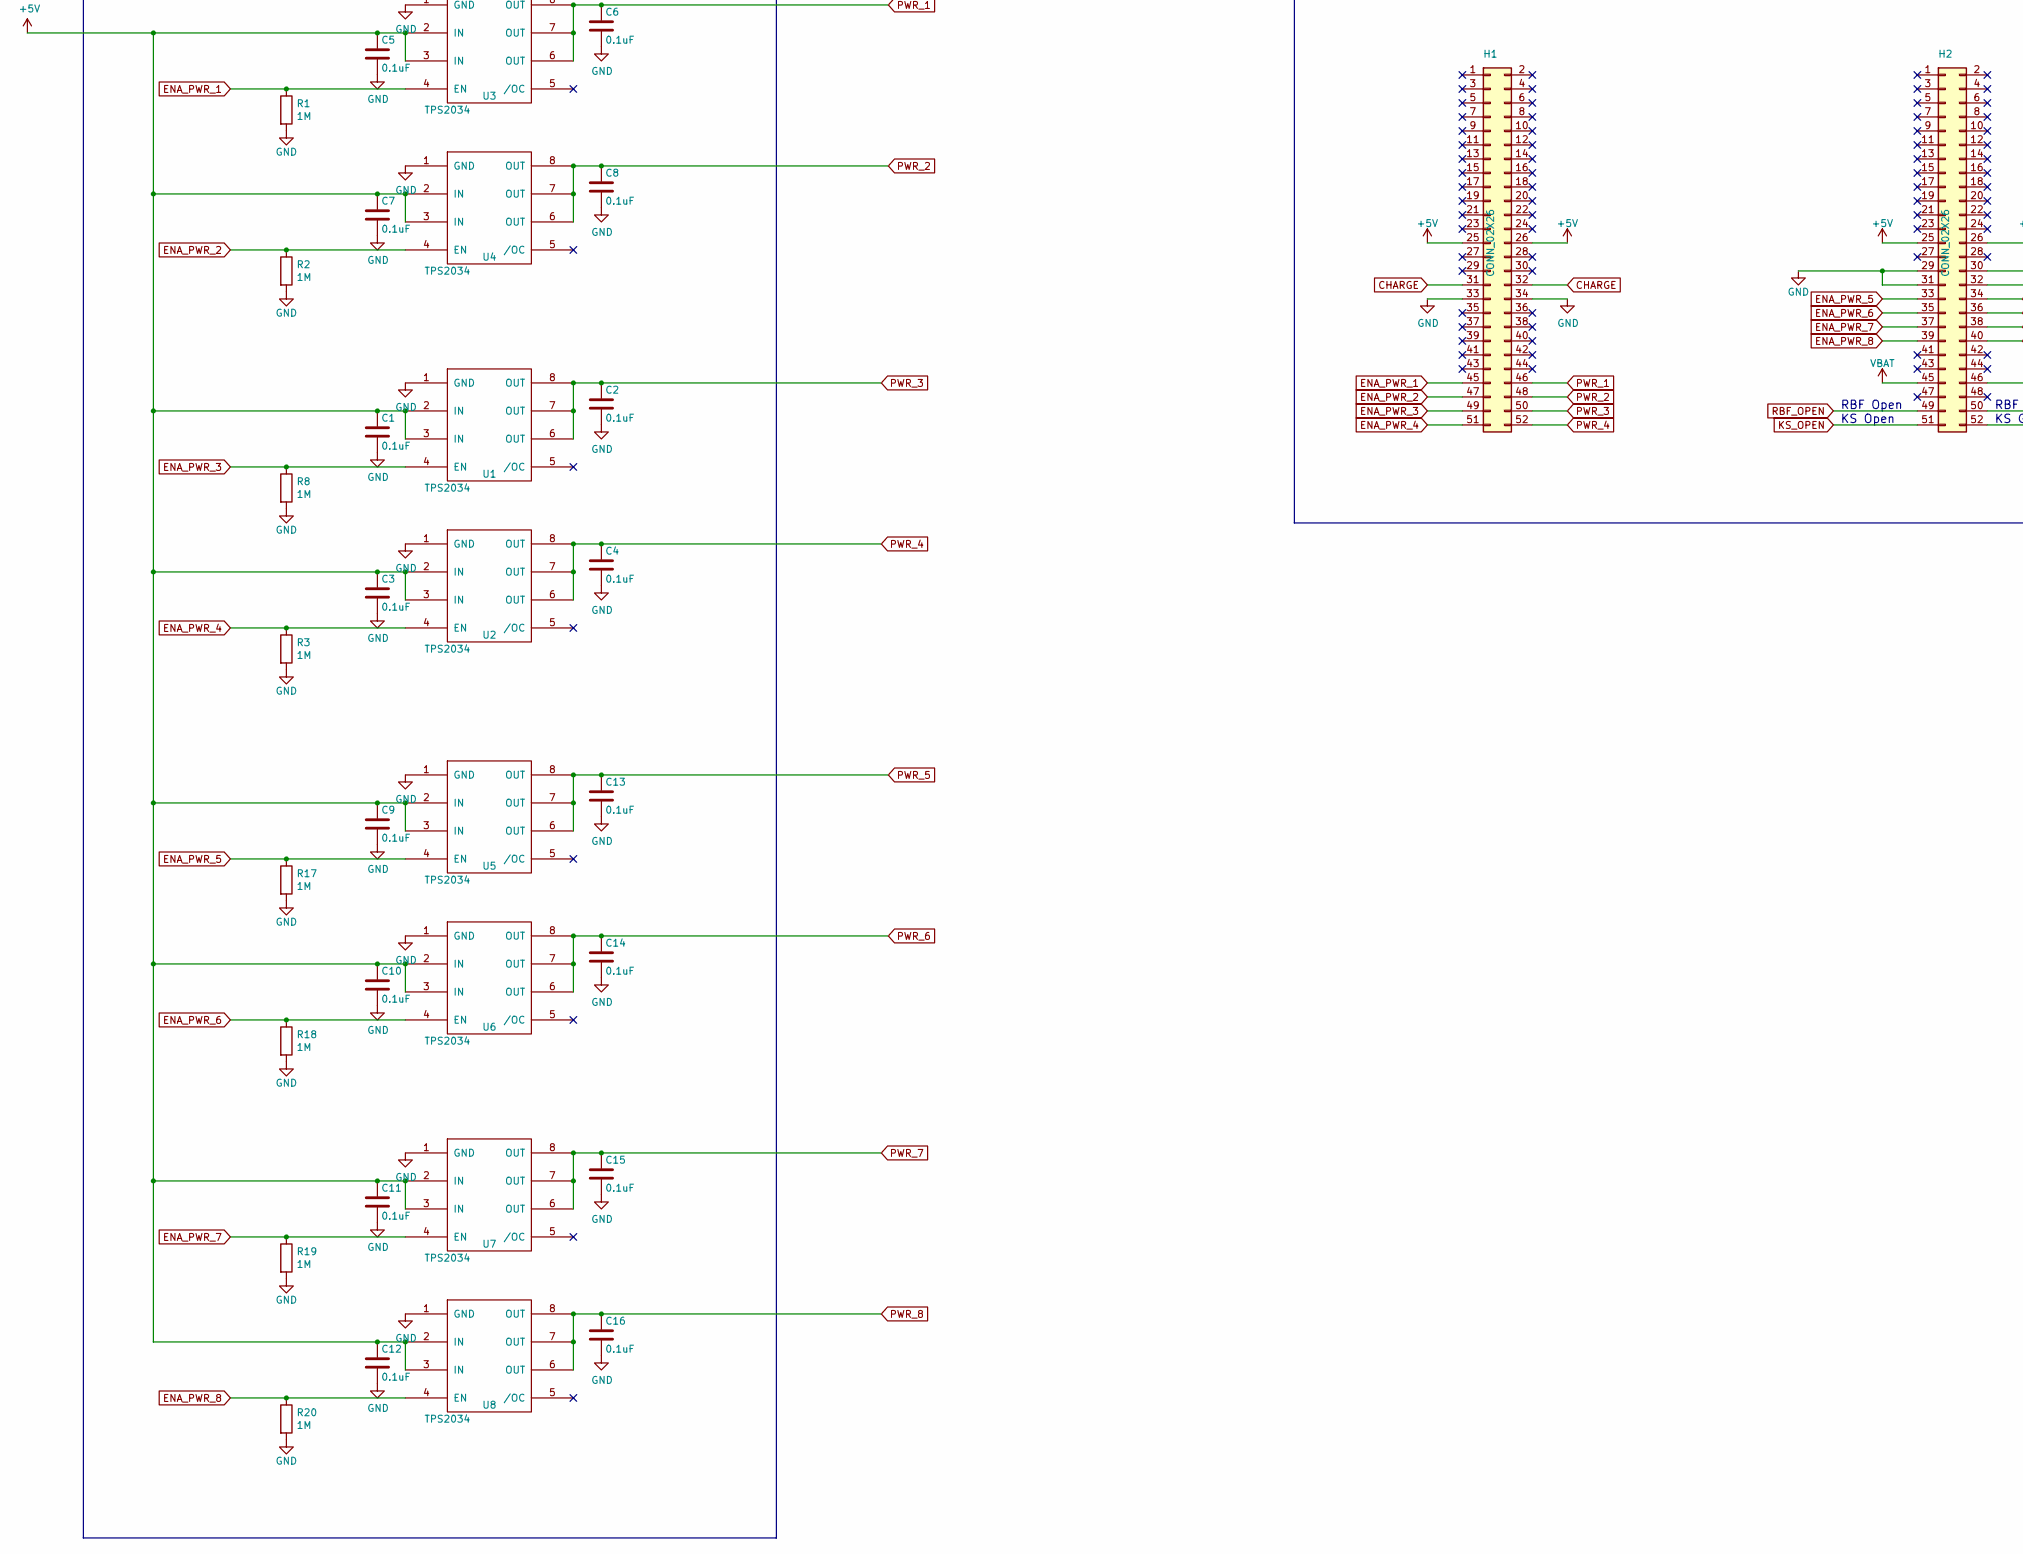
[picture p18: schematic pcdu.kicad_sch, Main, part in row 2, column 1]

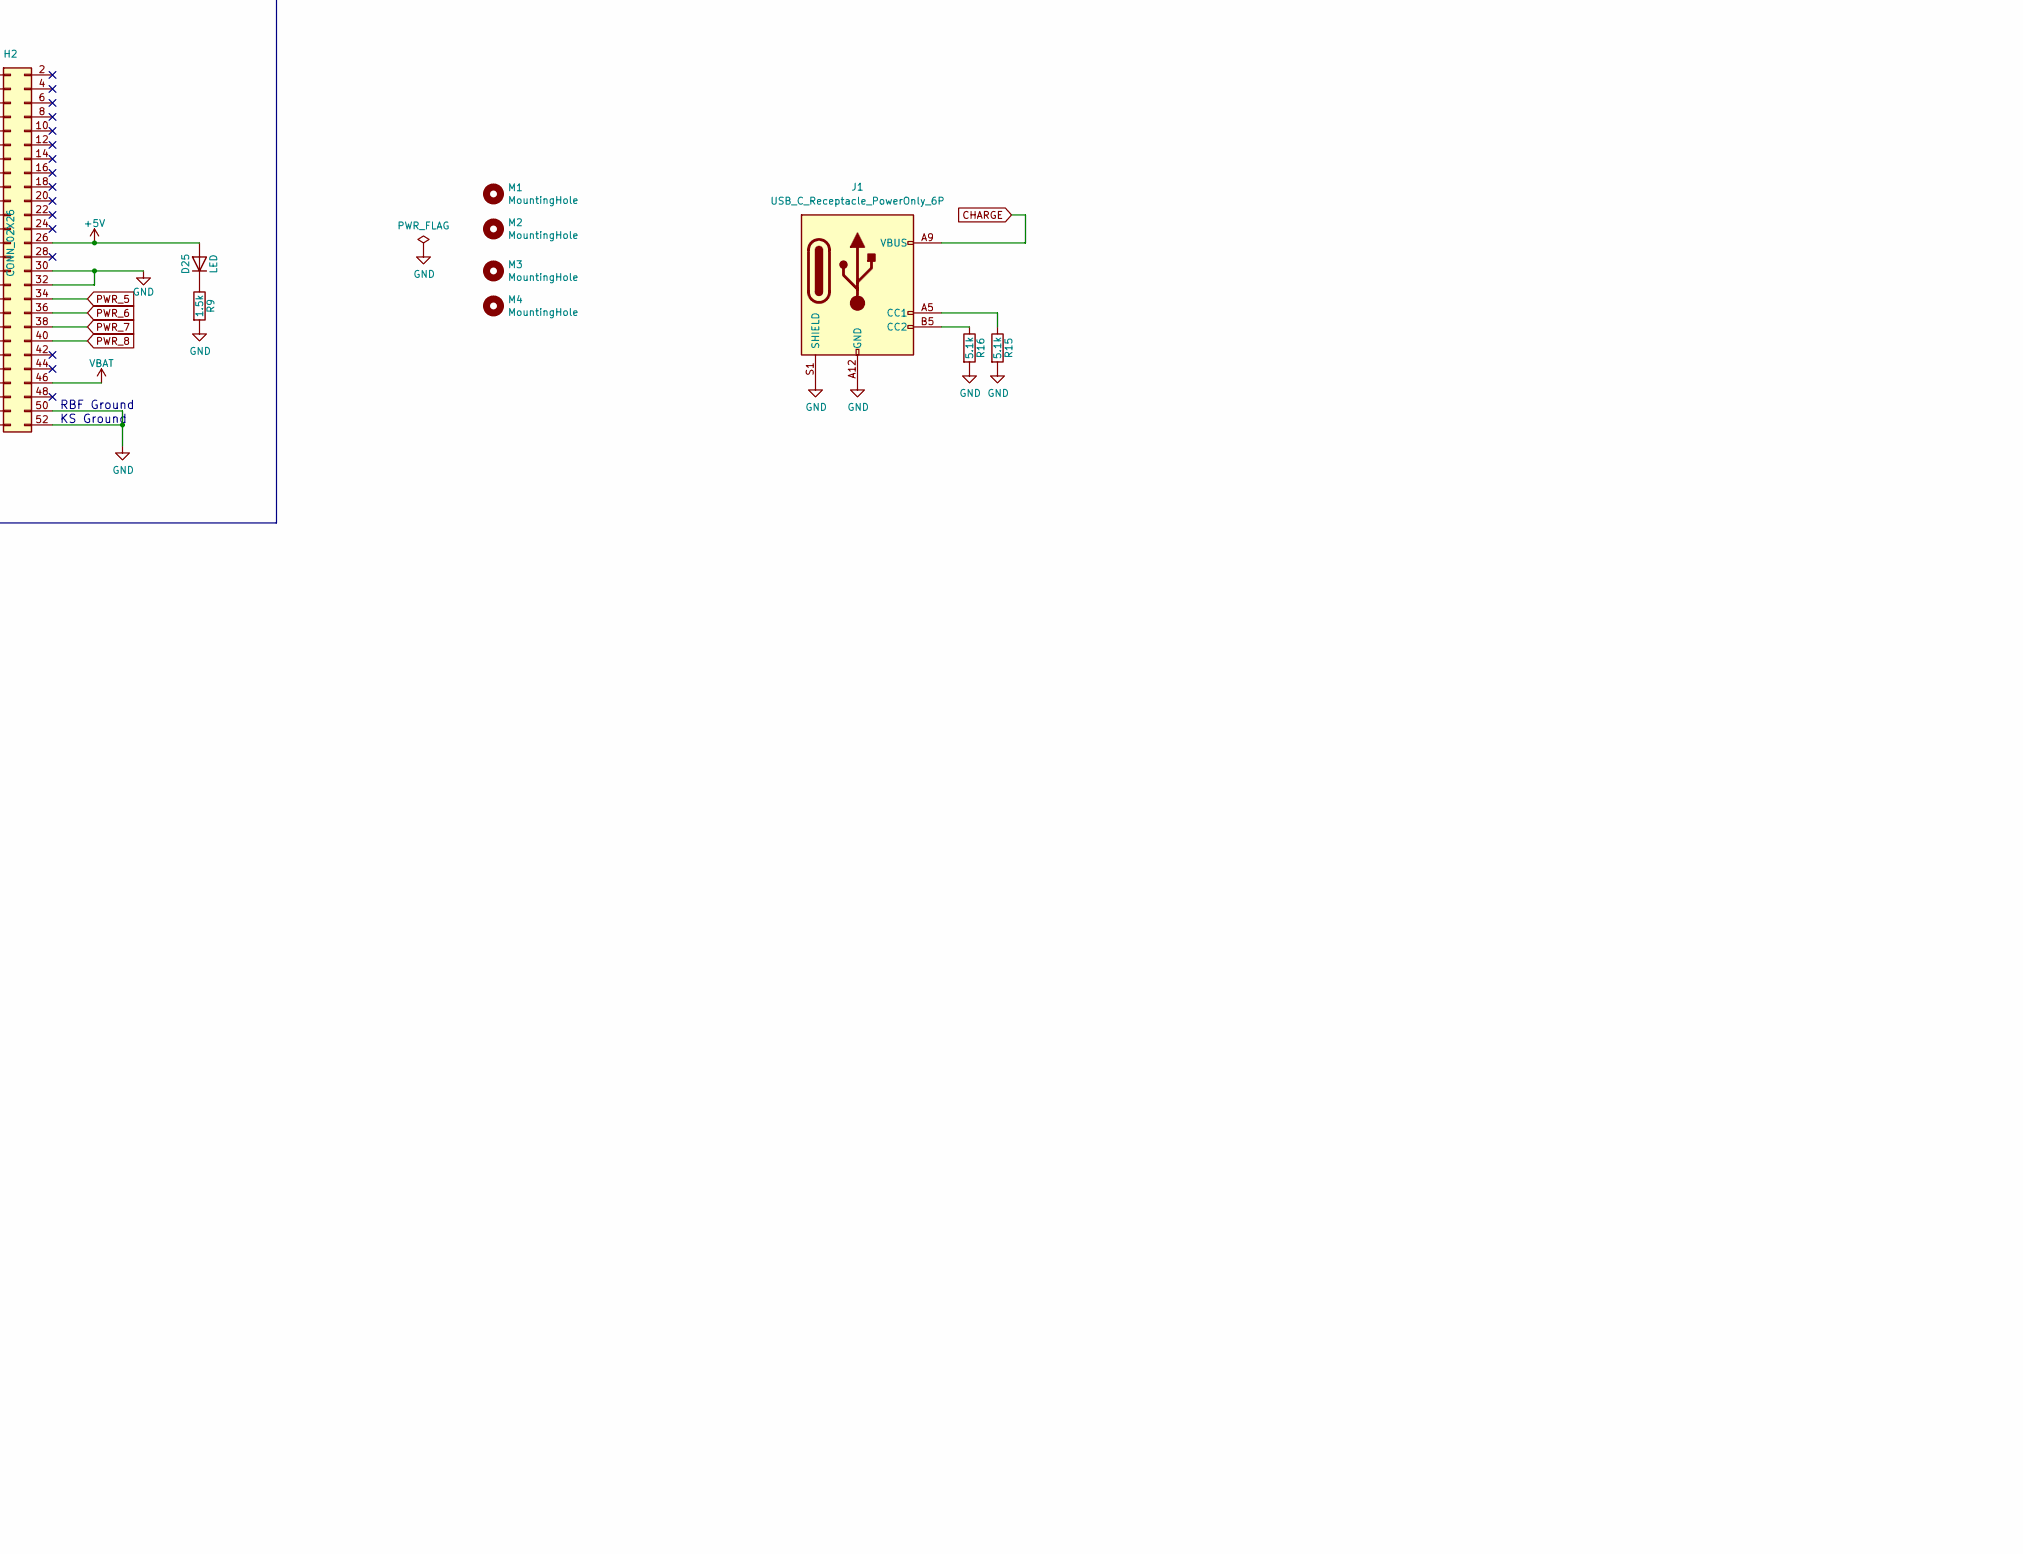
[picture p19: schematic pcdu.kicad_sch, Main, part in row 2, column 2]

Parts:
BT1, BT2: Battery_Cell; BatteryHolder_Keystone_1042_1x18650
C1, C2, C3, C4, C5, C6, C7, C8, C9, C10, C11, C12, C13, C14, C15, C16, C35, C36, C37, C38: 0.1uF; C_0805_2012Metric
C19, C21, C23, C25: 220uF; CP_EIA-7343-31_Kemet-D
C29, C32, C39, C45, C48, C50, C53, C56: 10uF; C_0805_2012Metric
C30, C33, C40, C51: 2.2uF; C_0805_2012Metric
C46, C54: 0.22uF; C_0805_2012Metric
D1, D2, D3, D4, D5, D6, D7, D8, D9, D10, D11, D12, D13, D14, D15, D16: D_Schottky; D_SOD-123
D17, D18, D19, D20, D25: LED; D_0805_2012Metric
H1, H2: CONN_02X26; ESQ-126-39-x-D
J1: USB_C_Receptacle_PowerOnly_6P; USB_C_Receptacle_GCT_USB4125-xx-x-0190_6P_TopMnt_Horizontal
J3, J4, J5, J6, J7, J8: Conn_01x02; PinHeader_1x02_P2.54mm_Horizontal
J9: Conn_01x02; PinHeader_1x02_P2.54mm_Vertical
L1, L2, L3, L4: 6.8uH; L_10.4x10.4_H4.8
M1, M2, M3, M4: MountingHole; MountingHole_3.2mm_M3_Pad
R1, R2, R3, R4, R8, R17, R18, R19, R20: 1M; R_0805_2012Metric
R9, R55, R56, R65, R66: 1.5k; R_0805_2012Metric
R15, R16: 5.1k; R_0805_2012Metric
R50, R60: 309k; R_0805_2012Metric
R51, R61: 110k; R_0805_2012Metric
R52, R62: 0.1; R_1206_3216Metric
U1, U2, U3, U4, U5, U6, U7, U8, U24, U25: TPS2034; SO-8_3.9x4.9mm_P1.27mm
U22, U23, U26, U33: TPS61032; HTSSOP-16-1EP_4.4x5mm_P0.65mm_EP3x3mm
U31, U34: bq24002; HTSSOP-20-1EP_4.4x6.5mm_P0.65mm_EP2.85x4mm

Connections:
+5V: C1.1, C3.1, C5.1, C7.1, C9.1, C10.1, C11.1, C12.1, C21.1, C23.1, C33.1, C40.1, D25.2 (A), H1.25, H1.26, H2.25, H2.26, U1.2 (IN), U1.3 (IN), U2.2 (IN), U2.3 (IN), U3.2 (IN), U3.3 (IN), U4.2 (IN), U4.3 (IN), U5.2 (IN), U5.3 (IN), U6.2 (IN), U6.3 (IN), U7.2 (IN), U7.3 (IN), U8.2 (IN), U8.3 (IN), U23.13 (VOUT), U23.14 (VOUT), U23.15 (VOUT), U26.13 (VOUT), U26.14 (VOUT), U26.15 (VOUT)
/Semi_Regulated_Bus: C35.1, C37.1, D13.1 (K), D14.1 (K), D15.1 (K), D16.1 (K), R4.1, U24.2 (IN), U24.3 (IN), U25.2 (IN), U25.3 (IN)
CHARGE: C29.1, C50.1, D1.1 (K), D2.1 (K), D3.1 (K), D4.1 (K), D5.1 (K), D6.1 (K), D7.1 (K), D8.1 (K), D9.1 (K), D10.1 (K), D11.1 (K), D12.1 (K), H1.31, H1.32, J1.A9 (VBUS), J1.B9 (VBUS), L1.2, L4.2, U22.6 (VBAT), U22.9 (EN), U33.6 (VBAT), U33.9 (EN)
ENA_PWR_1: H1.45, R1.1, U3.4 (EN)
ENA_PWR_2: H1.47, R2.1, U4.4 (EN)
ENA_PWR_3: H1.49, R8.1, U1.4 (EN)
ENA_PWR_4: H1.51, R3.1, U2.4 (EN)
ENA_PWR_5: H2.33, R17.1, U5.4 (EN)
ENA_PWR_6: H2.35, R18.1, U6.4 (EN)
ENA_PWR_7: H2.37, R19.1, U7.4 (EN)
ENA_PWR_8: H2.39, R20.1, U8.4 (EN)
GND: BT1.2 (-), BT2.2 (-), C1.2, C2.2, C3.2, C4.2, C5.2, C6.2, C7.2, C8.2, C9.2, C10.2, C11.2, C12.2, C13.2, C14.2, C15.2, C16.2, C19.2, C21.2, C23.2, C25.2, C29.2, C30.2, C32.2, C33.2, C35.2, C36.2, C37.2, C38.2, C39.2, C40.2, C45.2, C46.2, C48.2, C50.2, C51.2, C53.2, C54.2, C56.2, H1.33, H1.34, H2.29, H2.30, H2.31, H2.32, H2.50, H2.52, J1.A12 (GND), J1.B12 (GND), J1.S1 (SHIELD), J3.2, J4.2, J5.2, J6.2, J7.2, J8.2, J9.2, R1.2, R2.2, R3.2, R8.2, R9.2, R15.2, R16.2, R17.2, R18.2, R19.2, R20.2, R51.2, R61.2, U1.1 (GND), U2.1 (GND), U3.1 (GND), U4.1 (GND), U5.1 (GND), U6.1 (GND), U7.1 (GND), U8.1 (GND), U22.3 (PGND), U22.4 (PGND), U22.5 (PGND), U22.7 (LBI), U22.8 (SYNC), U22.11 (GND), U22.17 (PAD), U23.3 (PGND), U23.4 (PGND), U23.5 (PGND), U23.7 (LBI), U23.8 (SYNC), U23.11 (GND), U23.17 (PAD), U24.1 (GND), U25.1 (GND), U26.3 (PGND), U26.4 (PGND), U26.5 (PGND), U26.7 (LBI), U26.8 (SYNC), U26.11 (GND), U26.17 (PAD), U31.10 (GND), U31.13 (TMR_SEL), U31.16 (AGND), U33.3 (PGND), U33.4 (PGND), U33.5 (PGND), U33.7 (LBI), U33.8 (SYNC), U33.11 (GND), U33.17 (PAD), U34.10 (GND), U34.13 (TMR_SEL), U34.16 (AGND)
KS_OPEN: H2.49, H2.51, J9.1, R4.2, U24.4 (EN), U25.4 (EN)
unnamed: D1.2 (A), D2.2 (A), J3.1
unnamed: D3.2 (A), D4.2 (A), J4.1
unnamed: D5.2 (A), D6.2 (A), J5.1
unnamed: D7.2 (A), D8.2 (A), J6.1
unnamed: D9.2 (A), D10.2 (A), J7.1
unnamed: D11.2 (A), D12.2 (A), J8.1
unnamed: C19.1, C25.1, C30.1, C45.1, C51.1, C53.1, D13.2 (A), D14.2 (A), R50.1, R52.2, R55.1, R56.1, R60.1, R62.2, R65.1, R66.1, U22.13 (VOUT), U22.14 (VOUT), U22.15 (VOUT), U31.4 (VCC), U31.8 (EN), U31.9 (VSEL), U33.13 (VOUT), U33.14 (VOUT), U33.15 (VOUT), U34.4 (VCC), U34.8 (EN), U34.9 (VSEL)
unnamed: D17.2 (A), R55.2
unnamed: D17.1 (K), U31.15 (STAT2)
unnamed: D18.2 (A), R56.2
unnamed: D18.1 (K), U31.14 (STAT1)
unnamed: D19.2 (A), R65.2
unnamed: D19.1 (K), U34.15 (STAT2)
unnamed: D20.2 (A), R66.2
unnamed: D20.1 (K), U34.14 (STAT1)
unnamed: D25.1 (K), R9.1
unnamed: J1.A5 (CC1), R15.1
unnamed: J1.B5 (CC2), R16.1
unnamed: L1.1, U22.1 (SW), U22.2 (SW)
unnamed: L2.1, U23.1 (SW), U23.2 (SW)
unnamed: L3.1, U26.1 (SW), U26.2 (SW)
unnamed: L4.1, U33.1 (SW), U33.2 (SW)
unnamed: C32.1, C36.1, C38.1, C39.1, L2.2, L3.2, U23.6 (VBAT), U23.9 (EN), U24.6 (OUT), U24.7 (OUT), U24.8 (OUT), U25.6 (OUT), U25.7 (OUT), U25.8 (OUT), U26.6 (VBAT), U26.9 (EN)
unnamed: R50.2, R51.1, U31.7 (APG/THERM)
unnamed: C46.1, U31.12 (CR)
unnamed: R52.1, U31.2 (IN), U31.3 (IN), U31.5 (ISNS)
unnamed: R60.2, R61.1, U34.7 (APG/THERM)
unnamed: C54.1, U34.12 (CR)
unnamed: R62.1, U34.2 (IN), U34.3 (IN), U34.5 (ISNS)
PWR_1: C6.1, H1.46, U3.6 (OUT), U3.7 (OUT), U3.8 (OUT)
PWR_2: C8.1, H1.48, U4.6 (OUT), U4.7 (OUT), U4.8 (OUT)
PWR_3: C2.1, H1.50, U1.6 (OUT), U1.7 (OUT), U1.8 (OUT)
PWR_4: C4.1, H1.52, U2.6 (OUT), U2.7 (OUT), U2.8 (OUT)
PWR_5: C13.1, H2.34, U5.6 (OUT), U5.7 (OUT), U5.8 (OUT)
PWR_6: C14.1, H2.36, U6.6 (OUT), U6.7 (OUT), U6.8 (OUT)
PWR_7: C15.1, H2.38, U7.6 (OUT), U7.7 (OUT), U7.8 (OUT)
PWR_8: C16.1, H2.40, U8.6 (OUT), U8.7 (OUT), U8.8 (OUT)
VBAT: BT1.1 (+), BT2.1 (+), C48.1, C56.1, D15.2 (A), D16.2 (A), H2.45, H2.46, U31.17 (VSENSE), U31.18 (OUT`), U31.19 (OUT), U34.17 (VSENSE), U34.18 (OUT`), U34.19 (OUT)

Notes on the sheet:
Solar Array Input
90% charged
RBF Ground
KS Open
RBF Open
CubeSat Connector
KS Ground
Solar Array Regulator
Charging
System Power Switch
Power Distribution Unit
Power Conditioning Unit
System Power Regulator
Secure Lock
Battery Charger

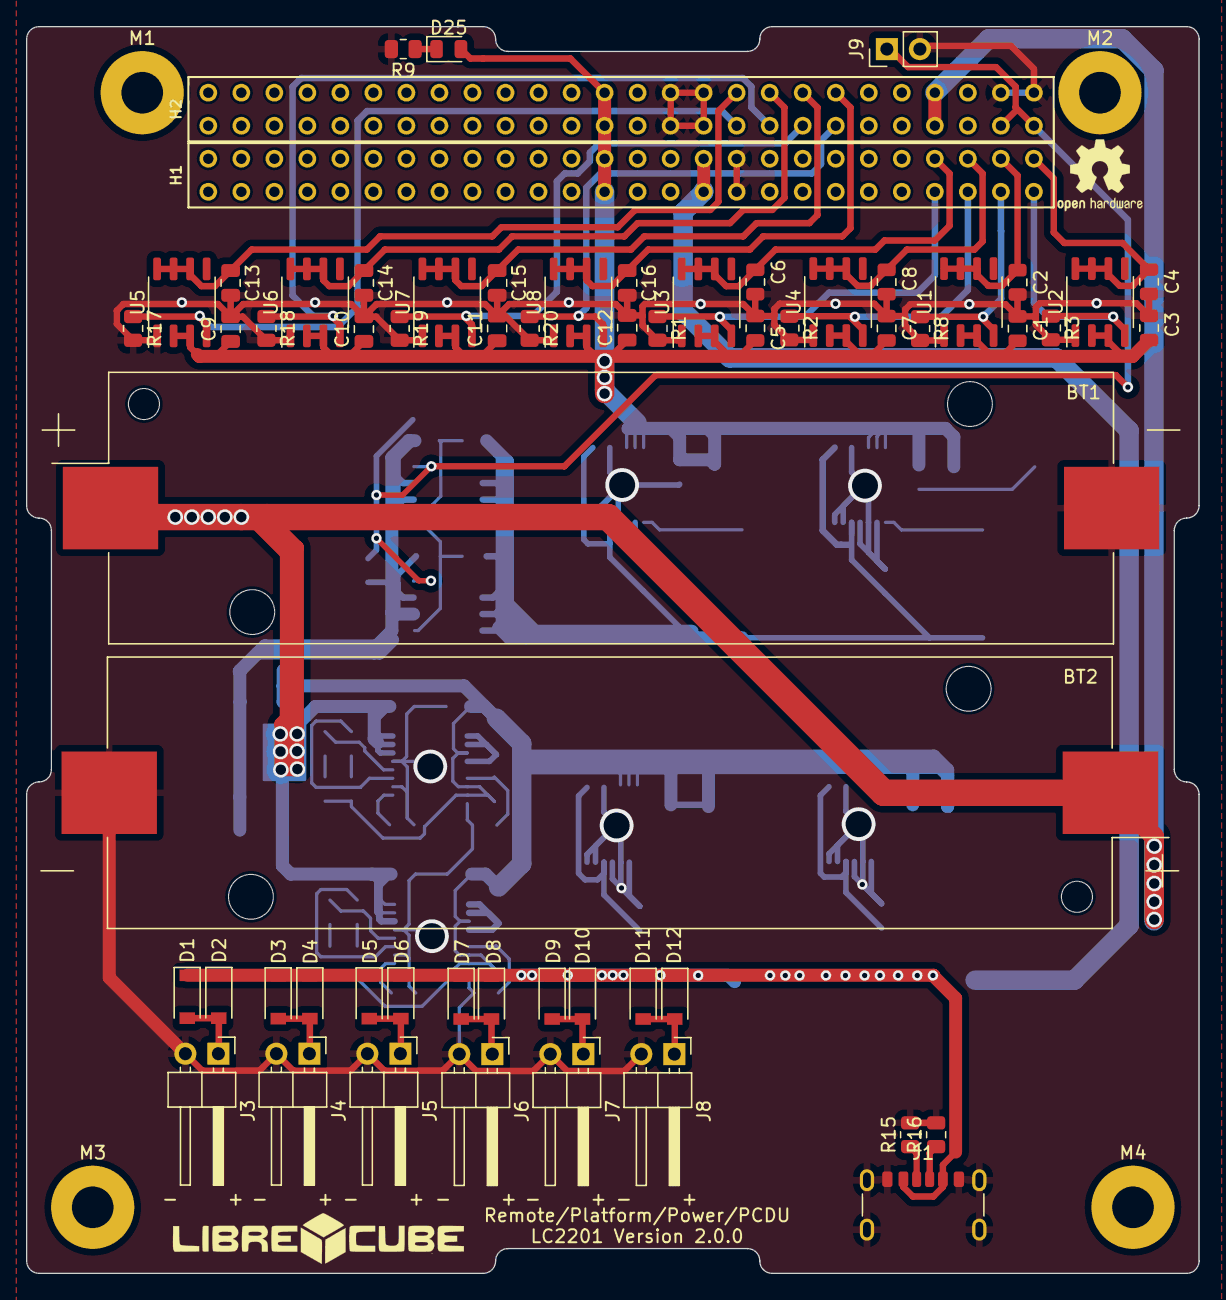
[picture p20: board pcdu.kicad_pcb from above]

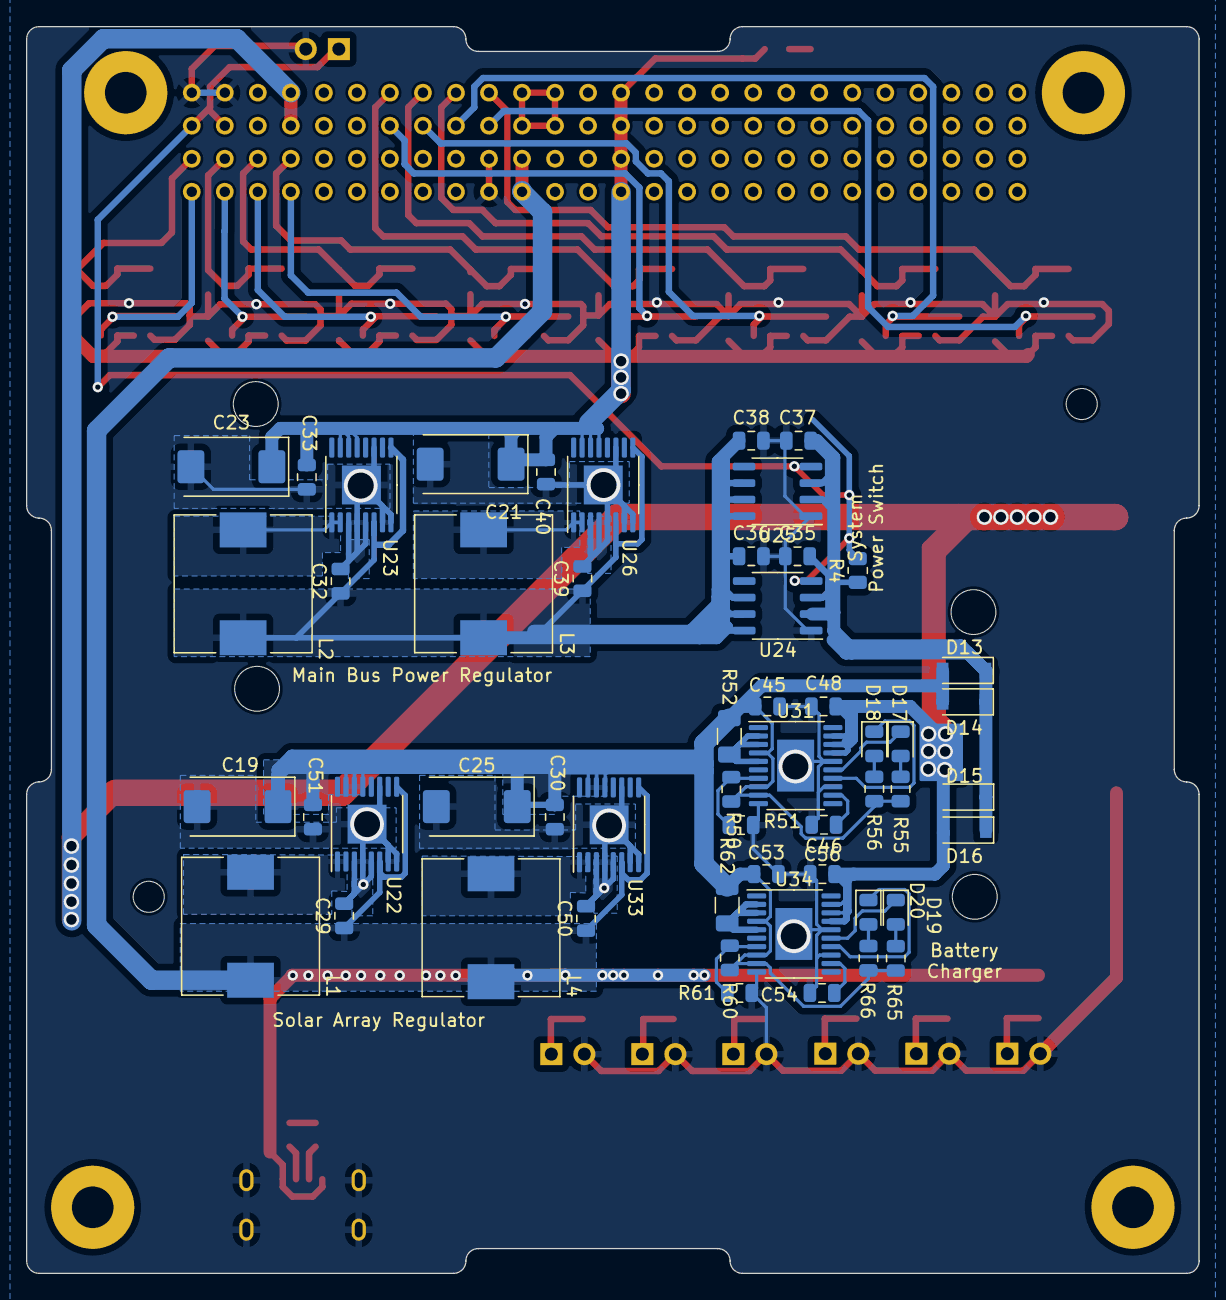
[picture p21: board pcdu.kicad_pcb from below]

Board: 2 copper layers, 90.2 x 95.9 mm, 117 parts (53 on the bottom side), 51 nets.
