GachuhiWachira/CubeSat/LibreCube PCDU/LibreCube Board Template/src/electrical/librecube_pcb_template.kicad_pcb

## KiCad design LibreCube PCDU/LibreCube Board Template/src/electrical/librecube_pcb_template.kicad_pcb (2024-09-18)

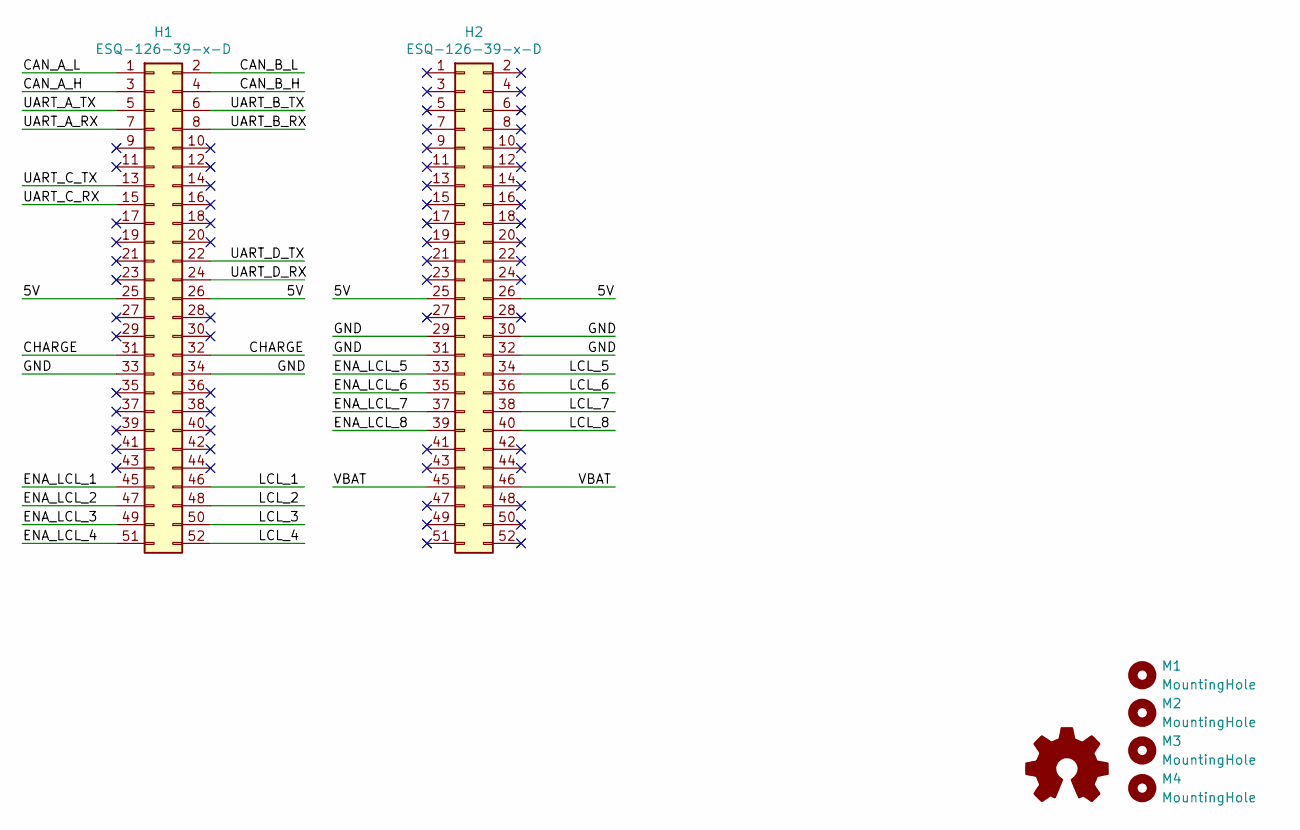
[picture p22: schematic librecube_pcb_template.kicad_sch]

Parts:
H1, H2: ESQ-126-39-x-D; PinHeader_2x26_P2.54mm_Vertical
M1, M2, M3, M4: MountingHole; MountingHole_3.2mm_M3_Pad

Connections:
/5V: H1.25, H1.26, H2.25, H2.26
/CAN_A_H: H1.3
/CAN_A_L: H1.1
/CAN_B_H: H1.4
/CAN_B_L: H1.2
/CHARGE: H1.31, H1.32
/ENA_LCL_1: H1.45
/ENA_LCL_2: H1.47
/ENA_LCL_3: H1.49
/ENA_LCL_4: H1.51
/ENA_LCL_5: H2.33
/ENA_LCL_6: H2.35
/ENA_LCL_7: H2.37
/ENA_LCL_8: H2.39
/GND: H1.33, H1.34, H2.29, H2.30, H2.31, H2.32
/LCL_1: H1.46
/LCL_2: H1.48
/LCL_3: H1.50
/LCL_4: H1.52
/LCL_5: H2.34
/LCL_6: H2.36
/LCL_7: H2.38
/LCL_8: H2.40
/UART_A_RX: H1.7
/UART_A_TX: H1.5
/UART_B_RX: H1.8
/UART_B_TX: H1.6
/UART_C_RX: H1.15
/UART_C_TX: H1.13
/UART_D_RX: H1.24
/UART_D_TX: H1.22
/VBAT: H2.45, H2.46

Board: 4 copper layers, 7 parts (0 on the bottom side), 4 nets, no tracks yet.

Other parts of the board:
REF1: Logo_Open_Hardware_Small; OSHW-Logo_5.7x6mm_SilkScreen
