GachuhiWachira/CubeSat/(commit log)

2024-08-06 Uploaded PCDU files
    [pcdu.kicad_pcb, pcdu.kicad_sch]
2024-08-06 Renamed the folders
    [bom.csv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]
2024-08-06 Included "My version"
    [bom.csv, pcdu.kicad_sch]
2024-08-06 Added PCB file
    [pcdu.kicad_pcb]
2024-08-06 Starting over
    [pcdu-v1.kicad_pcb, pcdu-v1.kicad_sch]
2024-08-06 new project
    [my_pcdu_v1.kicad_pcb, my_pcdu_v1.kicad_sch]
2024-08-06 More updates
    [my_pcdu_v1.kicad_pcb, my_pcdu_v1.kicad_sch]
2024-09-19 Uploaded PCDUv2
    [bom.csv, my_pcdu_v1.kicad_pcb, my_pcdu_v1.kicad_sch, pcdu.kicad_pcb, pcdu.kicad_sch]
2024-09-19 Updated Kicad Version
    [pcdu.kicad_pcb, pcdu.kicad_sch]
2024-09-20 Uploaded latest version from LibreCube
    [bom.csv, pcdu.kicad_pcb, pcdu.kicad_sch]
2024-09-29 New components
    [my_pcdu_v1.kicad_sch]
2024-10-01 PCDU updates
    [my_pcdu_v1.kicad_pcb, my_pcdu_v1.kicad_sch]
2024-10-03 PCB Layout
    [my_pcdu_v1.kicad_pcb, my_pcdu_v1.kicad_sch]
2024-10-08 EPS Routing
    [my_pcdu_v1.kicad_pcb, my_pcdu_v1.kicad_sch]
2025-06-20 PCDU finished
    [my_pcdu_v1.kicad_pcb]
2025-06-23 PCDU Complete
    [my_pcdu_v1.kicad_pcb]
